zhx-997/a-6-stage-pipeline-65nm-process-implementation-CPU/docs/design_report.docx

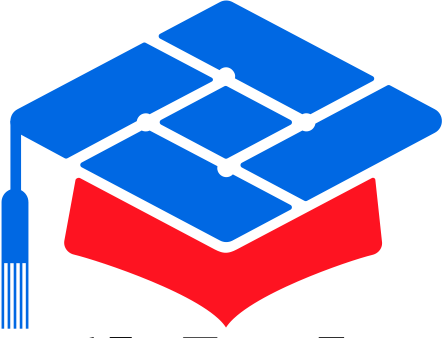
[picture p5: figure]

# 第十届

报告类型： 技术文档

参赛杯赛： “叩持”企业命题

作品名称： 六级流水线动态分支预测 CPU 设计

| | | | 目录
1 快速预览简介 | | | | | 3
1.1 关键技术 | | | | . . . . . . . . . . . . . . . . . . . . . . . . . . . . . . . . . . . | 3
1.2 重要指标 | | | | . . . . . . . . . . . . . . . . . . . . . . . . . . . . . . . . . . . | 4
2 项目概述 | | | | | 4
2.1 项目背景 | | | | . . . . . . . . . . . . . . . . . . . . . . . . . . . . . . . . . . . | 4
2.2 设计目标 | | | | . . . . . . . . . . . . . . . . . . . . . . . . . . . . . . . . . . . | 5
3 | CPU 微架构设计 | | | | 5
| 3.1 RV32I 指令集支持总览 . . . . . . . . . . . . . . . . . . . . . . . . . . . . | | | | 5
| 3.2 六级流水线总体架构 . . . . . . . . . . . . . . . . . . . . . . . . . . . . . | | | | 8
| 3.3 核心模块详细设计 . . . . . . . . . . . . . . . . . . . . . . . . . . . . . . | | | | 9
| 3.3.1 取指单元：PC、IM 与 IR 模块 . . . . . . . . . . . . . . . . . . . | | | | 9
| 3.3.2 译码与控制单元：ControlUnit 自设计说明 . . . . . . . . . . . . | | | | 11
| 3.3.3 执行单元：ALU 与 NPC . . . . . . . . . . . . . . . . . . . . . . | | | | 17
| 3.3.4 访存单元：DM 及其流水线寄存器 . . . . . . . . . . . . . . . . . | | | | 18
| 3.3.5 寄存器堆（RF） . . . . . . . . . . . . . . . . . . . . . . . . . . . | | | | 19
| 3.4 数据冲突处理（Hazard 控制单元） . . . . . . . . . . . . . . . . . . . . . | | | | 20
| 3.4.1 数据前递（Forwarding） . . . . . . . . . . . . . . . . . . . . . . | | | | 20
| 3.4.2 流水线停顿（Stall） . . . . . . . . . . . . . . . . . . . . . . . . . | | | | 21
| 3.4.3 流水线冲刷（Flush） . . . . . . . . . . . . . . . . . . . . . . . . | | | | 22
| 3.5 动态分支预测 . . . . . . . . . . . . . . . . . . . . . . . . . . . . . . . . . | | | | 23
| 3.5.1 预测器结构 . . . . . . . . . . . . . . . . . . . . . . . . . . . . . . | | | | 23
| 3.5.2 预测与恢复流程 . . . . . . . . . . . . . . . . . . . . . . . . . . . | | | | 23
4 | 验证与性能分析 | | | | 24
| 4.1 仿真验证 . . . . . . . . . . . . . . . . . . . . . . . . . . . . . . . . . . . | | | | 24
4.1.1 | | | 测试样例 . . . . . . . . . . . . . . . . . . . . . . . . . . . . . . . | | 24
4.1.2 | | | 验证过程 . . . . . . . . . . . . . . . . . . . . . . . . . . . . . . . | | 27
4.1.3 | | | 调试问题记录 . . . . . . . . . . . . . . . . . . . . . . . . . . . . . | | 33
5 逻辑综合 | | | | | 34
5.1 | | 工艺库与设计环境搭建 . . . . . . . . . . . . . . . . . . . . . . . . . . . . | | | 37
| | 5.1.1 SRAM . . . . . . . . . . . . . . . . . . . . . . . . . . . . . . . . . | | | 37
| | 5.1.2 标准单元库 (.db) . . . . . . . . . . . . . . . . . . . . . . . . . . . | | | 41
5.2 | | 时序约束与接口建模 . . . . . . . . . . . . . . . . . . . . . . . . . . . . . | | | 41
| | 5.2.1 路径设置与库锁定 . . . . . . . . . . . . . . . . . . . . . . . . . . | | | 41

  1.1 关键技术

1 快速预览简介

#### 表 1—处理器主要迭代版本对比

架构类型 最大主频 | 数据内存 | CPI | 分支预测 | 数据冲突处理
单周期 50.00 MHz | SRAM | 1.00 | 无 | 无
五级流水线 83.33 MHz | SRAM | 1.11 | 静态不跳转 | 全通道
六级流水线 173.90 MHz | SRAM | 1.25 | 动态 (BTB + 1-bit BHT) | 全通道前递 + 停顿 + 冲刷

#### 六级流水线架构：在经典五级流水线（IF-ID-EX-MEM-WB）基础上，将访存阶段拆分为 ME1 和 ME2 两个子阶段。ME1 负责地址传递与写使能/写数据准备， ME2 完成 SRAM 的实际读写与数据对齐。该拆分有效降低了访存相关组合路径的时序压力。在当前 Design Compiler 综合约束下，主时钟周期设置为 5.75 ns，对应目标频率约为 173.9 MHz。综合阶段最差建立时间裕量为 0.02 ns，时序状态为 MET。

#### 最终提交的RTL 文件riscv.v 已存放于：/home/project/cp_training_backend1/ users/cpu117/target/CPU_final/rtl

#### 最终提交的综合脚本文件script 已存放于：/home/project/cp_training_backend1/ users/cpu117/target/CPU_final/dc_output

#### 最终提交的网表文件 riscv_out.v 和riscv_out.sdc 已存放于：/home/project/ cp_training_backend1/users/cpu117/target/CPU_final/dc_output

#### 动态分支预测：采用 8 项分支目标缓存（BTB）与 1 位分支历史表（BHT）组成的局部动态预测器。BTB 记录跳转目标地址，BHT 提供简单的” 跳转/不跳转”方向预测。预测成功时零停顿；预测失败时通过流水线冲刷（Flush）丢弃误取的两条指令并修正 PC，控制冒险惩罚固定为两个时钟周期。

- 完备的数据冲突处理：支持从 MEM1、MEM2 到 EX 阶段的全流水段数据前递

#### （Forwarding），可消除多数 RAW 冒险；针对 Load-Use 冒险，由冲突控制逻辑在 ID 阶段插入一拍停顿（Stall）；分支误预测触发 IF/ID 和 ID/EX 两级流水线冲刷，所有冲突处理均集成在 ControlUnit 中统一调度，确保指令执行的精确正确性。

#### 模块化设计与规范：顶层模块严格按照流水线阶段划分，包含取指（PC/IM/IR）、译码（RF/EXT）、执行（ALU）、访存（DM）以及集中式的控制与冲突管理单元

#### （ControlUnit）。各模块接口清晰、职责单一，符合 RTL 设计的可移植与可集成要求，符合叩持官方命题规范。

#### 综合优化与时序收敛：基于台积电 65 nm 低功耗工艺（SS 工艺角，1.08 V，125 ℃）完成逻辑综合。采用寄存器重定时（compile_ultra -retime）、SRAM 接口路径高权重分组（weight=5.0）及分段式线负载模型等策略。在最严苛条件下，设计以 5.75 ns 周期达成建立时间收敛（Slack = +0.02 ns），最高工作频率稳定达到 174 MHz。

  1.2 重要指标

#### 表 2—处理器重要指标汇总

指标项目 具体参数值

指令集架构 (ISA) RV32I（基本整数指令集子集，覆盖 16 条基础指令）

#### 流水线深度 六级（IF – ID – EX – ME1 – ME2 – WB）

#### 最大主频 173.9 MHz（1000/5.75 ns）

#### 综合工艺 TSMC 65 nm LP，SS 工艺角（1.08V，125℃）

最差建立时间裕量 +0.02 ns（MET）

平均 CPI 约 1.2

- 指令集架构 (ISA)：RV32I（基本整数指令集子集，覆盖 16 条基础指令）

#### 流水线深度：六级（IF –ID –EX –ME1 –ME2 –WB）

- 综合阶段目标频率：约 173.9 MHz（时钟周期 5.75 ns）

#### 综合工艺与条件：TSMC 65 nm 低功耗工艺，最差工艺角（SS，1.08 V，125 ℃）

- 综合阶段最差建立时间裕量：+0.02 ns，时序状态为 MET

#### 平均 CPI：约 1.2～1.4（受 Load-Use 停顿及分支误预测冲刷共同影响，具体取决于程序指令流特征）

#### 测试覆盖：企业定向测试 16 项全部通过

2 项目概述
  2.1 项目背景

#### 设计采用 ASIC 全流程开发方法，基于 Verilog RTL 描述，使用 VCS/Verdi 进行功能仿真与波形调试，通过 Synopsys Design Compiler 完成逻辑综合，借助 Cadence Innovus实现物理设计与时序收敛，完整覆盖从 RTL 到 GDS 的数字 IC 开发全流程。为在满足物理设计约束的同时获得更高性能，我们在经典五级流水线基础上进行了深度优化，设计了一款六级流水线处理器，并引入动态分支预测技术以进一步发掘指令级并行度。

  2.2 设计目标

#### 本项目旨在设计与实现一款基于 RISC-V RV32I 指令集的六级流水线处理器，具体目标包括：

#### 完整支持 RV32I 基本整数指令集，覆盖其定义的全部整数运算、访存及控制转移指令。

#### 流水线深度为六级（IF –ID –EX –ME1 –ME2 –WB），在满足建立/保持时间约束的前提下，尽可能提升工作主频。

#### 实现基于 BTB 与 BHT 的动态分支预测，有效降低条件分支引起的流水线冲刷次数。

#### 具备全路径数据前递、Load-Use 停顿及分支误预测冲刷机制，确保所有 RAW 数据冒险与控制冒险均能被正确处理。

#### 顶层模块划分与接口完全符合叩持官方设计要求，便于集成、验证及后端物理实现。

3 CPU 微架构设计
  3.1 RV32I 指令集支持总览

#### 本设计完整实现了 RV32I 整数指令集中定义的 16 条核心指令，包括：

- 算术运算：ADD, SUB, ADDI

#### 逻辑与移位：AND, OR, XOR, ORI, SLL, SRL, SRA,

- 比较与分支：BEQ, BNE
- 加载与存储：LW, SW
- 跳转与链接：JAL, JALR

#### 此外，得益于 I-type 译码逻辑中 funct3 各码点的完备覆盖，XORI、SLLI、SRLI、SRAI四条立即数指令无需额外硬件即可自然支持，实际可执行指令共计 20 条。

#### 表 3—RV32I 指令集格式支持详情表

31 25 24 20 19 15 14 12 11 7 6 0

U lui

imm[31:12] | | | | rd | 0110111
imm[31:12] | | | | rd | 0010111
imm[20|10:1|11|19:12] | | | | rd | 1101111
imm[11:0] | | rs1 | 000 | rd | 1100111
imm[12|10:5] | rs2 | rs1 | 000 | imm[4:1|11] | 1100011
imm[12|10:5] | rs2 | rs1 | 001 | imm[4:1|11] | 1100011
imm[12|10:5] | rs2 | rs1 | 100 | imm[4:1|11] | 1100011
imm[12|10:5] | rs2 | rs1 | 101 | imm[4:1|11] | 1100011
imm[12|10:5] | rs2 | rs1 | 110 | imm[4:1|11] | 1100011
imm[12|10:5] | rs2 | rs1 | 111 | imm[4:1|11] | 1100011
imm[11:0] | | rs1 | 000 | rd | 0000011
imm[11:0] | | rs1 | 001 | rd | 0000011
imm[11:0] | | rs1 | 010 | rd | 0000011
imm[11:0] | | rs1 | 100 | rd | 0000011
imm[11:0] | | rs1 | 101 | rd | 0000011
imm[11:5] | rs2 | rs1 | 000 | imm[4:0] | 0100011
imm[11:5] | rs2 | rs1 | 001 | imm[4:0] | 0100011
imm[11:5] | rs2 | rs1 | 010 | imm[4:0] | 0100011
imm[11:0] | | rs1 | 000 | rd | 0010011
imm[11:0] | | rs1 | 010 | rd | 0010011
imm[11:0] | | rs1 | 011 | rd | 0010011
imm[11:0] | | rs1 | 100 | rd | 0010011
imm[11:0] | | rs1 | 110 | rd | 0010011
imm[11:0] | | rs1 | 111 | rd | 0010011
0000000 | shamt | rs1 | 001 | rd | 0010011
0000000 | shamt | rs1 | 101 | rd | 0010011
0100000 | shamt | rs1 | 101 | rd | 0010011
0000000 | rs2 | rs1 | 000 | rd | 0110011
0100000 | rs2 | rs1 | 000 | rd | 0110011
0000000 | rs2 | rs1 | 001 | rd | 0110011
0000000 | rs2 | rs1 | 010 | rd | 0110011
0000000 | rs2 | rs1 | 011 | rd | 0110011
0000000 | rs2 | rs1 | 100 | rd | 0110011
0000000 | rs2 | rs1 | 101 | rd | 0110011
0100000 | rs2 | rs1 | 101 | rd | 0110011
0000000 | rs2 | rs1 | 110 | rd | 0110011
0000000 | rs2 | rs1 | 111 | rd | 0110011

U auipc J jal

I jalr B beq B bne B blt B bge B bltu B bgeu I lb

I lh I lw I lbu I lhu S sb S sh S sw

I addi I slti I sltiu I xori I ori

I andi I slli

I srli I srai

R add R sub R sll R slt R sltu R xor R srl R sra R or R and

  3.2 六级流水线总体架构

#### 与经典五级流水线相比，本设计的核心改进在于将访存阶段（MEM）细分为 ME1

#### 和 ME2 两个阶段。

#### ME1 阶段负责将 ALU 计算结果作为访存地址传递至数据存储器接口，同时锁存写使能信号与待写入数据（RD2）；

#### ME2 阶段利用同步 SRAM 完成实际存储访问，读出的数据在 WB 阶段经由多路选择器送入寄存器文件。

#### 该拆分使 MEM 阶段的长组合路径被两级流水线寄存器截断，关键路径延时显著降低，是主频从约 100 MHz 提升至 174 MHz 的关键。

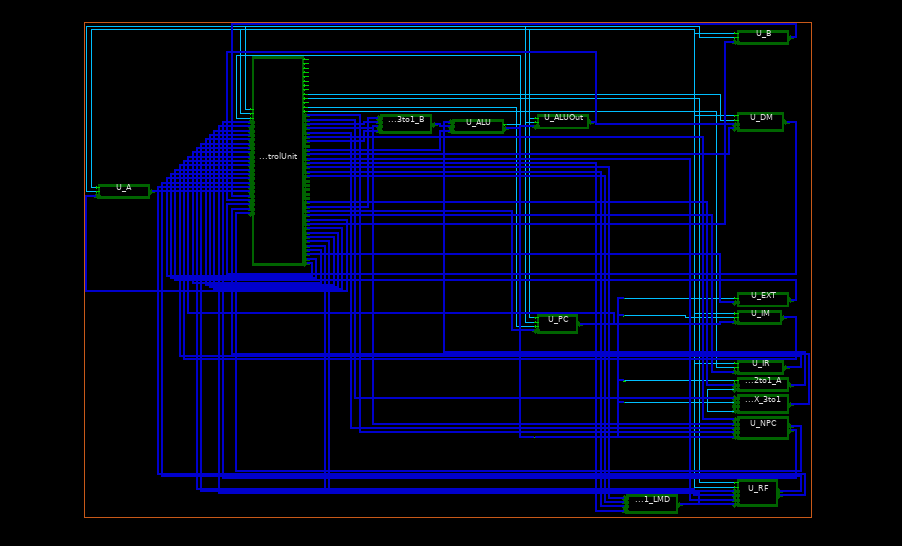
[picture p6: figure]

#### 图 1—六级流水线总体架构 RTL 连线图

#### 图 2—六级流水线架构简图六级流水线各阶段核心功能如下：

#### 1. IF（取指）：PC 模块输出当前指令地址，指令存储器 IM 在时钟下降沿取出指令； ControlUnit 内的分支预测器根据 BTB/BHT 状态产生下一 PC 预测值，指导取指流向。

#### 2. ID（译码）：ControlUnit 对指令进行译码，产生各级所需控制信号；寄存器堆 RF

#### 读出两个源操作数 RD1/RD2；EXT 模块生成符号扩展后的 32 位立即数。

#### 3. EX（执行）：ALU 完成算术、逻辑、比较及地址计算等操作；分支指令的实际跳转方向与目标地址在此阶段计算得出，ControlUnit 将其与预测结果进行比对，若预测失败则产生流水线冲刷信号。

#### 4. ME1（访存 1）：将 ALU 计算结果作为访存地址传递至数据存储器，同步锁存写使能信号与待写入数据；该阶段为 SRAM 读写提供稳定的地址/控制/数据建立时间。

5. ME2（访存 2）：数据存储器 DM 在时钟上升沿完成实际读写操作；读操作时，

#### DR_WB 锁存从 SRAM 输出的原始数据，供下一阶段进一步处理。

#### 6. WB（写回）：多路选择器 MUX-3to1-LMD 根据 WDSel-WB 控制信号，从以下三路中选取最终写回值：ALU 运算结果、数据存储器读出数据或返回地址 PC+4。选通的 WD 在时钟上升沿写入寄存器堆 RF 中由 WR-WB 指定的目标寄存器。

  3.3 核心模块详细设计
    3.3.1 取指单元：PC、IM 与 IR 模块

#### PC 模块：程序计数器，支持复位与停顿。当 actual_PCWrite 有效非复位时，在时钟上升沿将最终下一条 PC 值 final_next_pc 锁存输出。复位时 PC 初始化为 0x0000_2000。

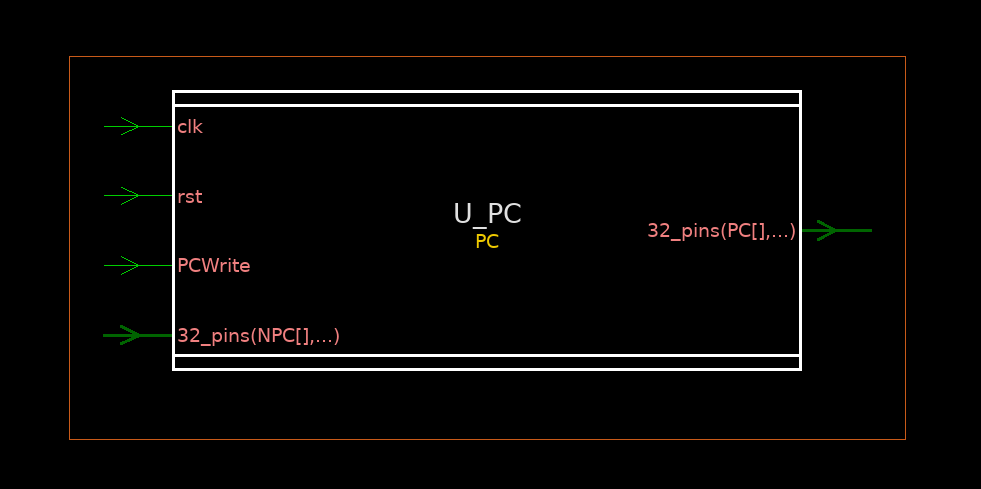
[picture p7: figure]

#### 图 3—PC 模块图

#### IM 模块：指令存储器例化了一颗台积电 65 nm 工艺的同步 SRAM 宏单元

#### TS1N65LPLL2048X64M8，该宏单元容量为 2048 深度 × 64 位宽。CPU 通过 10

#### 位地址总线 PC[11:2] 寻址，实际使用宏单元的低 1024 个入口、每个入口的低 32

#### 位数据，等效逻辑深度为 1024 × 32 位（即 1024 条 32 位 RV32I 指令）。SRAM宏单元在系统时钟 clk 的上升沿完成指令读取，各控制引脚连接如下：

#### 表 4—SRAM 引脚连接说明

SRAM 引脚 | 连接值 | 含义
CLK | clk | 系统时钟，上升沿触发
CEB | 1’b0 | 芯片使能，常有效
WEB | 1’b1 | 写使能，常无效（IM 只读）
A | {1’b0, PC[11:2]} | 11 位字地址，高位置 0
D | 64’b0 | 写数据，常接 0（IM 不写入）
BWEB | {64{1’b1}} | 字节写掩码，全 1 表示全部屏蔽
TSEL | 2’b01 | 正常操作模式
Q | Q_full | 64 位读出数据

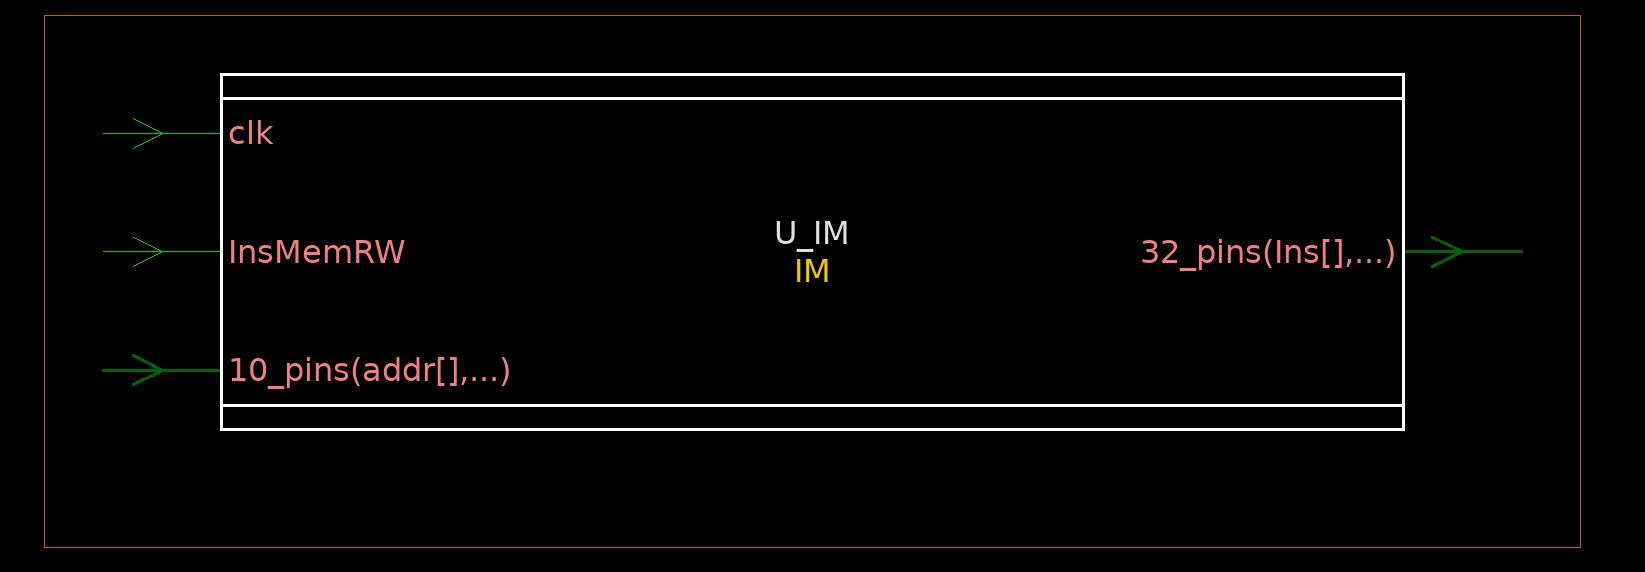
[picture p8: figure]

#### 图 4—IM 模块图

#### IR 模块：指令寄存器 IR 为 IF/ID 阶段的流水线边界寄存器。在 actual-IRWrite

#### 有效时，于时钟上升沿将 actual-in-ins 锁存输出至 out-ins。

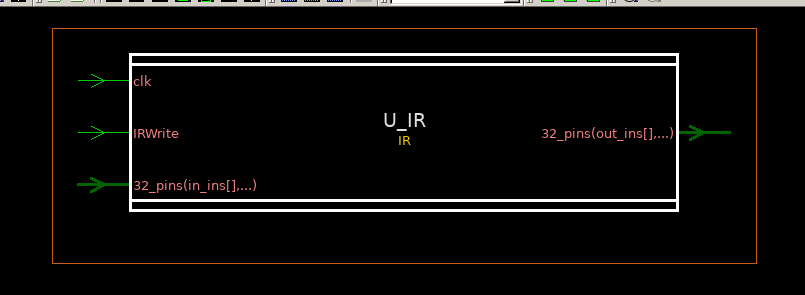
[picture p9: figure]

#### 图 5—IR 模块图

    3.3.2 译码与控制单元：ControlUnit 自设计说明

#### ControlUnit 是本设计的核心模块，集中实现了指令译码、流水线控制信号生成、数据冲突检测与处理、动态分支预测四大功能。该模块采用组合逻辑与状态寄存器混合设计，在单个模块内维护了 IF→ID→EX→MEM1→MEM2→WB 六级流水线的全部控制状态。

#### 主译码：译码阶段为纯组合逻辑，以 out-opcode（当前指令的 7 位操作码）为输入，产生 12 组控制信号，默认值与各指令类型的对应关系如下表：

#### 表 5—控制单元输出控制信号表

控制信号 | 默认值（空 | R-type | I-type | LW | SW | B-type | JAL | JALR
RFWrite | 0 | 1 | 1 | 1 | 0 | 0 | 1 | 1

闲/NOP）

DMCtrl RD

(0)

RD RD RD WR

RD RD RD

ALUSrcA A

(0)

A A A A A A A

(1)

B

B B

ALUSrcB B

(00)

Imm

(01)

Imm

(01)

Offset

(10)

Imm

(01)

ALUOp ADD func 译码 func 译码 ADD ADD BR ADD ADD

NPCOp PC(00) PC PC PC PC Offset12

(01)

Offset20

(11)

WDSel FromALU FromALU | FromALU | FromMEM (01) | FromALU | FromALU | FromPC (10) | FromPC (10)
RegSel rd rd | rd | rd | rd | rd | rd | rd
ExtSel SIGNED SIGNED | SIGNED | SIGNED | SIGNED | SIGNED | SIGNED | SIGNED

rs

(10)

(00)

(00)

(1)

#### 指令字段提取与安全译码：在译码之前，ControlUnit 先通过 valid-IR 机制确保指令的有效性：复位后首个时钟周期 valid-IR = 0，此时 safe-out-ins 被强制替换为 32’h00000013（NOP），防止无效的 IR 初始值（32’hxxxxxxxx）触发错误的控制信号。第二周期起 valid-IR = 1，译码正常进行。指令的各字段通过组合逻辑从 safe-out-ins 中直接截取。立即数字段 out-Offset 与 out-Offset20 按 RISC-V 规范进行位重排

#### 实流水线寄存器链：ControlUnit 内部维护了五组流水线寄存器，将 ID 阶段产生的控制信号和分支预测信息逐级传递至后续阶段：

#### 1. 流水级边界:IF→ID 锁存的关键信号:PC 值、分支预测方向/目标、顺序 PC+4

#### 2. 流水级边界:ID→EX 锁存的关键信号: 全部控制信号、操作数地址、立即数、预测信息

#### 3. 流水级边界:EX→MEM1 锁存的关键信号:PC+4、写回地址/使能/选择、DM控制与写数据

#### 4. 流水级边界:MEM1→MEM2 锁存的关键信号:PC+4、写回地址/使能/选择、

#### ALU 结果

#### 5. 流水级边界:MEM2→WB 锁存的关键信号: 写回地址/使能/选择、ALU 结果、

#### DM 读出数据、PC+4

I | clk | 1 | 时钟信号
I | rst | 1 | 异步复位，高有效
I | zero | 1 | ALU 零标志，用于分支判定
I | opcode | 7 | 指令操作码
I | Funct7 | 7 | 指令 funct7 域
I | Funct3 | 3 | 指令 funct3 域
I | rs1 | 5 | 源寄存器 1 地址
I | rs2 | 5 | 源寄存器 2 地址
I | rd | 5 | 目的寄存器地址
I | PC | 32 | 当前 PC 值 (IF 阶段)
I | in_ins | 32 | 从 IM 取出的原始指令
I | out_ins | 32 | IR 输出指令 (有效后)
I | Imm32 | 32 | 立即数扩展结果
I | Offset | 12 | B 型/S 型偏移量
I | Offset20 | 20:1 | J 型偏移量 (20 位，不含最低位)
I | RD1 | 32 | 寄存器堆读出数据 1
I | RD2 | 32 | 寄存器堆读出数据 2
I | RD1_r | 32 | ID/EX 锁存后的 RD1
I | RD2_r | 32 | ID/EX 锁存后的 RD2
I | ALU_result_r | 32 | EX/MEM1 锁存后的 ALU 结果
I | RD | 32 | 数据存储器读出数据
I | WR | 5 | 写回寄存器号 (来自 MUX_3to1)
I | WD | 32 | 最终写回数据
I | PCA4_wire | 32 | NPC 模块输出的 PC+4
I | NPC_wire | 32 | NPC 模块计算的目标地址

#### 表 6—ControlUnit 控制单元输入信号接口说明

方向 信号名 位宽 功能描述输入信号 (Input Signals)

O | PCWrite | 1 | 基础 PC 写使能 (停顿前)
O | InsMemRW | 1 | 指令存储器读使能
O | IRWrite | 1 | 基础 IR 写使能 (停顿前)
O | RFWrite | 1 | ID 段寄存器堆写使能
O | DMCtrl | 1 | 数据存储器读写控制 (1 = 写)
O | ExtSel | 1 | 立即数扩展选择 (0 = 零扩展, 1 = 符号扩展)
O | ALUSrcA | 1 | ALU A 口选择 (0 = 前递数据, 1 = 移位量)
O | ALUSrcB | 2 | ALU B 口选择 (00 = 前递, 01 = 立即数, 10 = 偏移量)
O | NPCOp | 2 | NPC 操作码 (00 = +4, 01 = B 型, 10 = rs, 11 = J 型)
O | WDSel | 2 | 写回数据选择 (00 = ALU, 01 = MEM, 10 = PC+4)
O | RegSel | 2 | 目的寄存器选择 (00 = rd, 01 = rt, 10 = x31)
O | ALUOp | 4 | ALU 操作码

输出信号 - 流水线寄存器 (EX 阶段)
O | PC_EX | 32 | EX 阶段 PC 值
O | rd_EX | 5 | EX 阶段目的寄存器地址
O | Imm32_EX | 32 | EX 阶段立即数
O | Offset_EX | 12 | EX 阶段 B/S 型偏移量
O | Offset20_EX | 20:1 | EX 阶段 J 型偏移量
O | ALUSrcA_EX | 1 | EX 阶段 ALUSrcA
O | NPCOp_EX | 2 | EX 阶段 NPCOp
O | ALUSrcB_EX | 2 | EX 阶段 ALUSrcB
O | RegSel_EX | 2 | EX 阶段 RegSel
O | ALUOp_EX | 4 | EX 阶段 ALUOp

输出信号 - 流水线寄存器 (MEM1 阶段)
O | DMCtrl_MEM | 1 | MEM1 阶段数据存储器控制
O | RD2_MEM | 32 | MEM1 阶段写入数据 (前递后)

#### 表 7—ControlUnit 控制单元输出信号接口说明

方向 信号名 位宽 功能描述输出信号 - 控制类 (Control Outputs)

O | WR_WB | 5 | WB 阶段写回寄存器号
O | RFWrite_WB | 1 | WB 阶段寄存器堆写使能
O | WDSel_WB | 2 | WB 阶段写回数据选择
O | ALU_result_WB | 32 | WB 阶段 ALU 结果
O | PCA4_WB | 32 | WB 阶段 PC+4
O | DR_WB | 32 | WB 阶段数据存储器读出

输出信号 - 冲突处理相关 (Hazards & Forwarding)
O | forwardA_data | 32 | A 操作数前递数据
O | forwardB_data | 32 | B 操作数前递数据
O | final_next_pc | 32 | 最终下一条 PC (考虑预测/冲刷)
O | load_use_stall | 1 | Load-Use 冒险停顿标志
O | actual_in_ins | 32 | 送入 IR 的实际指令 (可能为 NOP)
O | true_RD1 | 32 | 经写回前递后的 RD1
O | true_RD2 | 32 | 经写回前递后的 RD2

输出信号 - 指令译码字段 (Decode Fields)
O | out_opcode | 7 | 译码后操作码
O | out_Funct7 | 7 | 译码后 funct7
O | out_Funct3 | 3 | 译码后 funct3
O | out_rs1 | 5 | 译码后 rs1 地址
O | out_rs2 | 5 | 译码后 rs2 地址
O | out_rd | 5 | 译码后 rd 地址
O | out_Imm12 | 12 | 译码后 12 位立即数
O | out_Offset | 12 | 译码后偏移量 (B/S 型)
O | out_Offset20 | 20:1 | 译码后 20 位偏移量

输出信号 - 实际写使能 (Actual Write Enables)
O | actual_PCWrite | 1 | 经过停顿处理的实际 PC 写使能
O | actual_IRWrite | 1 | 经过停顿处理的实际 IR 写使能

#### 表 8—ControlUnit 控制单元输出信号接口说明 (续)

方向 信号名 位宽 功能描述输出信号 - 流水线寄存器 (WB 阶段)

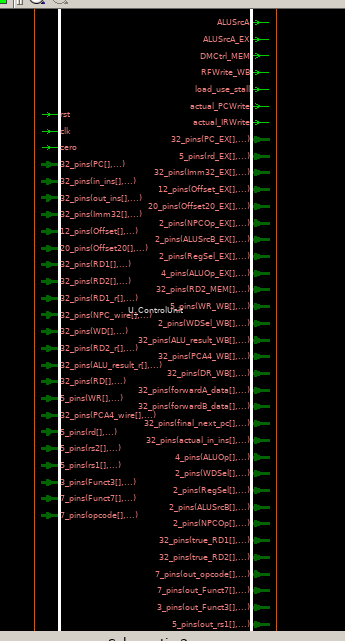
[picture p10: figure]

#### 图 6—ControlUnit 说明图

    3.3.3 执行单元：ALU 与 NPC

#### ALU：纯组合逻辑，支持加减、逻辑、移位及比较操作，由 ALUOp 信号选择，输出运算结果及 zero 标志。

#### 表 9—各路多路选择器 (MUX) 模块及控制信号定义

模块名称 控制信号 输入选择 功能描述

MUX_2to1_A

(ALU 端口 A 选择)

ALUSrcA_EX 1'b0: forwardA_data 选择来自rs1 的数据或前递数据，用

于处理数据冒险。

1'b1: 5'b0 选择零扩展后的位移量 (sa)。

(ALU 端口 B 选择)

MUX_3to1_B ALUSrcB_EX | 2'b00: | forwardB_data | 选择来自 rs2 的数据或前递数据。
| 2'b01: | Imm32_EX | 选择由 EXT 模块扩展后的 32 位立即数。
| 2'b10: | Offset_EX | 选择分支指令或存储指令所需的偏移量。
| 2'b11: | forwardB_data | 默认选择前递通路数据。
MUX_3to1_LMD ( WDSel_WB | 2'b00: | ALU_result_WB | 将 EX 段运算结果写回寄存器堆。
| 2'b01: | DR_out | 将内存加载 (Load) 的数据写回寄存器堆。
| 2'b10: | PCA4_WB | 将 PC + 4 写回，用于跳转指令保存返回地址。
| 2'b11: | 0 | 备用状态。
MUX_3to1 ( RegSel_EX | 2'b00: | rd_EX | 使用指令中定义的 rd 域作为目标寄存器。
| 2'b01: | 5'd0 | 备用状态，通常对应 R-type 中的其他编码。
| 2'b10: | 5'd31 | 固定选择 31 号寄存器 (ra) 进行跳转保存。
| 2'b11: | 0 | 默认值。

寄存器写回选择)

写回地址选择)

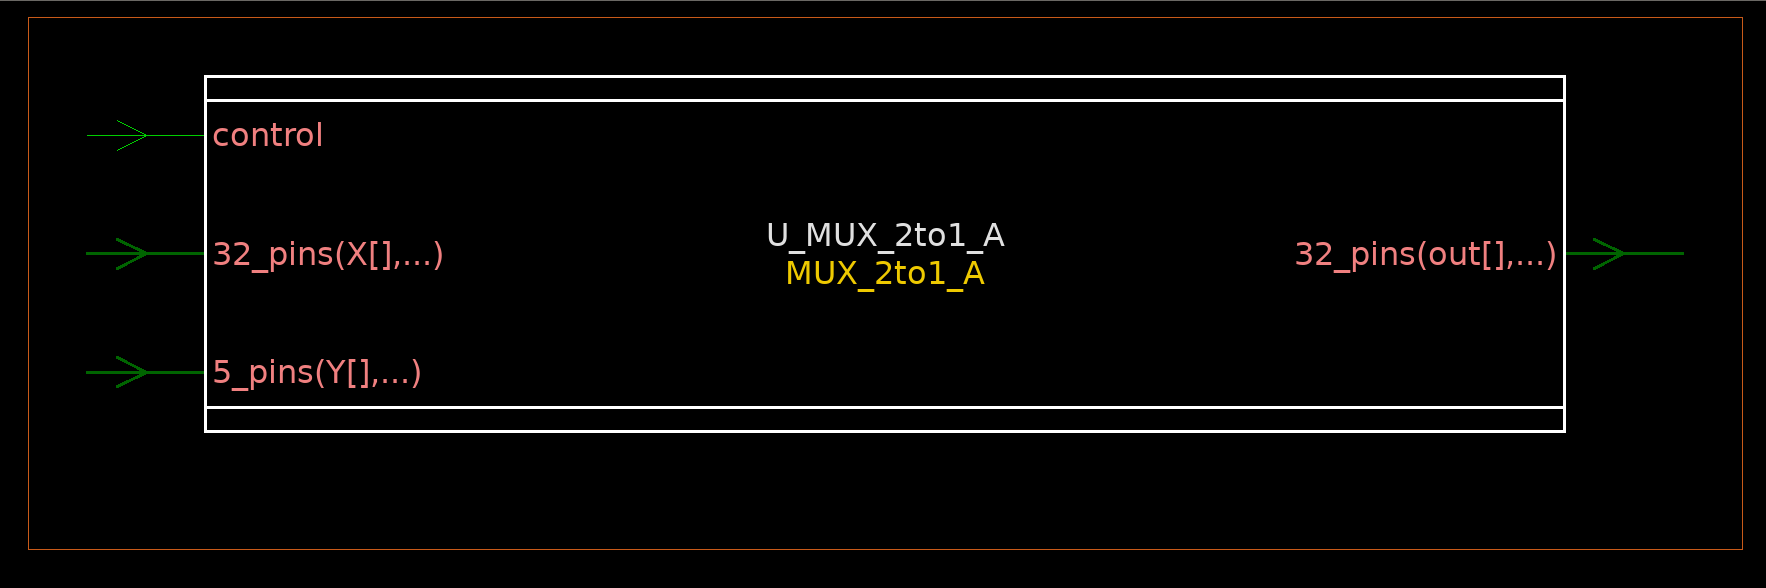
[picture p11: figure]

#### 图 7—MUX_2tol_A 模块图

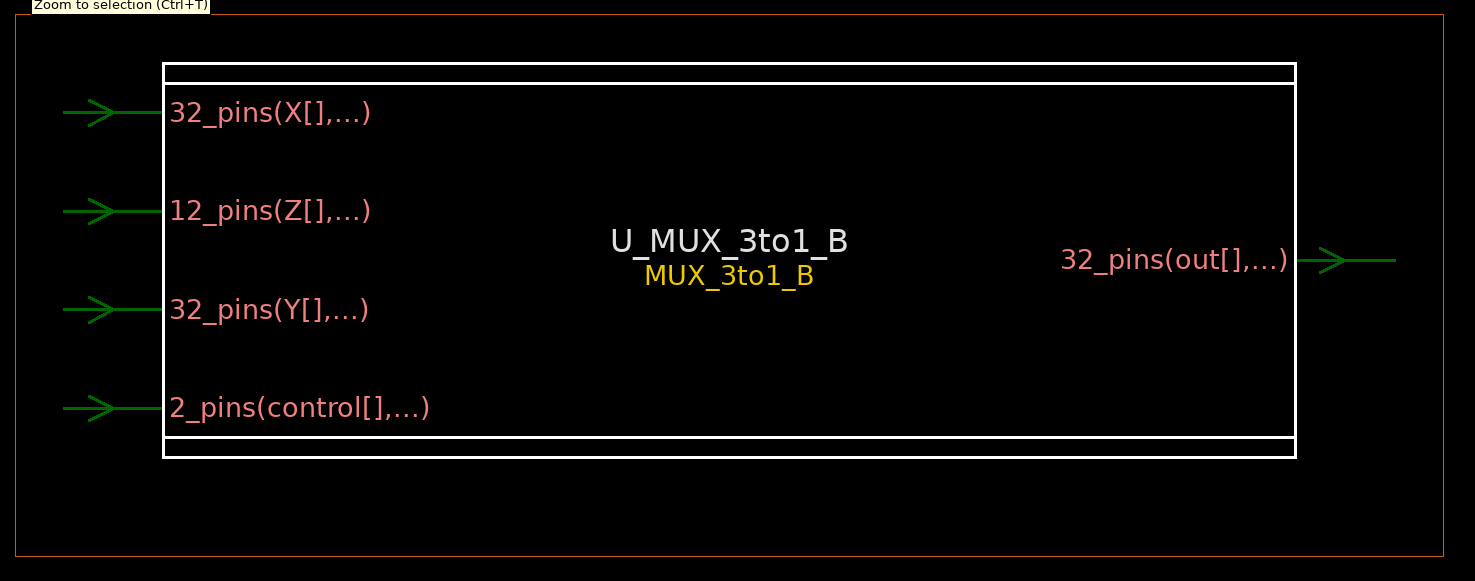
[picture p12: figure]

#### 图 8—MUX_3tol_B 模块图

#### NPC 模块：位于 EX 段，根据 NPCOp_EX 控制信号与 PC_EX、偏移量等计算分支/跳转的实际目标地址 NPC_wire。

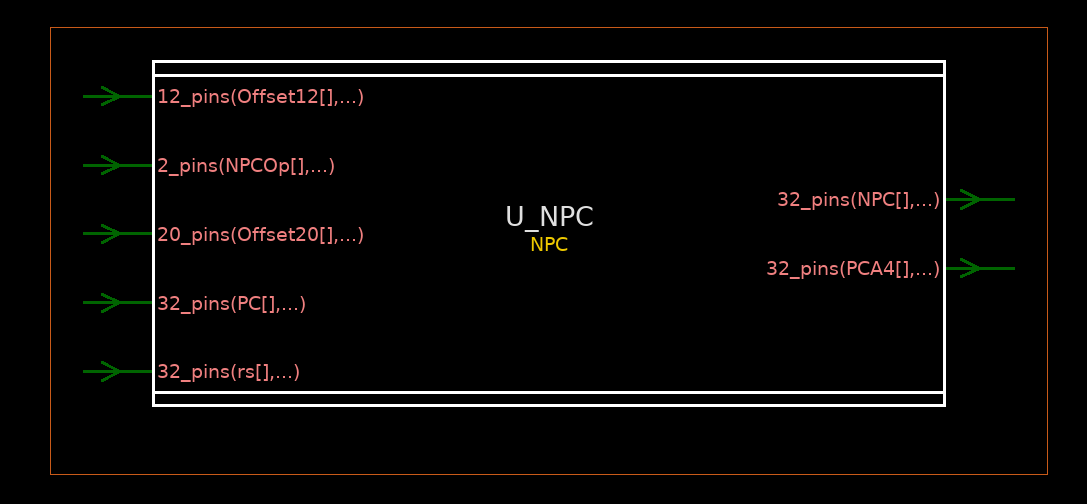
[picture p13: figure]

#### 图 9—NPC 模块图

    3.3.4 访存单元：DM 及其流水线寄存器

#### 数据存储器DM 与IM 使用同一型号的台积电 65 nm 同步SRAM 宏单元TS1N65LPLL2048X64M

#### （2048 深度 × 64 位宽）。CPU 以 10 位地址 ALU_result_r[11:2] 寻址宏单元的低 1024个入口，每个入口使用低 32 位数据，等效逻辑深度为 1024 × 32 位。DM 的各 SRAM控制引脚连接如下：

#### 表 10—DM SRAM 引脚连接说明

SRAM 引脚 | 连接值 | 含义
CLK | clk | 系统时钟，上升沿触发
CEB | 1'b0 | 芯片使能，常有效
WEB | ~DMCtrl | DMCtrl=1（写）→ WEB=0；DMCtrl=0（读）→ WEB=1
A | {1'b0, Addr} | 11 位地址，高位置 0
D | {32'b0, WD} | 写数据置于低 32 位
BWEB | 64'b0 | 字节写掩码，全 0 = 全部字节可写
TSEL | 2'b01 | 正常操作模式
Q | Q_full | 64 位读出数据

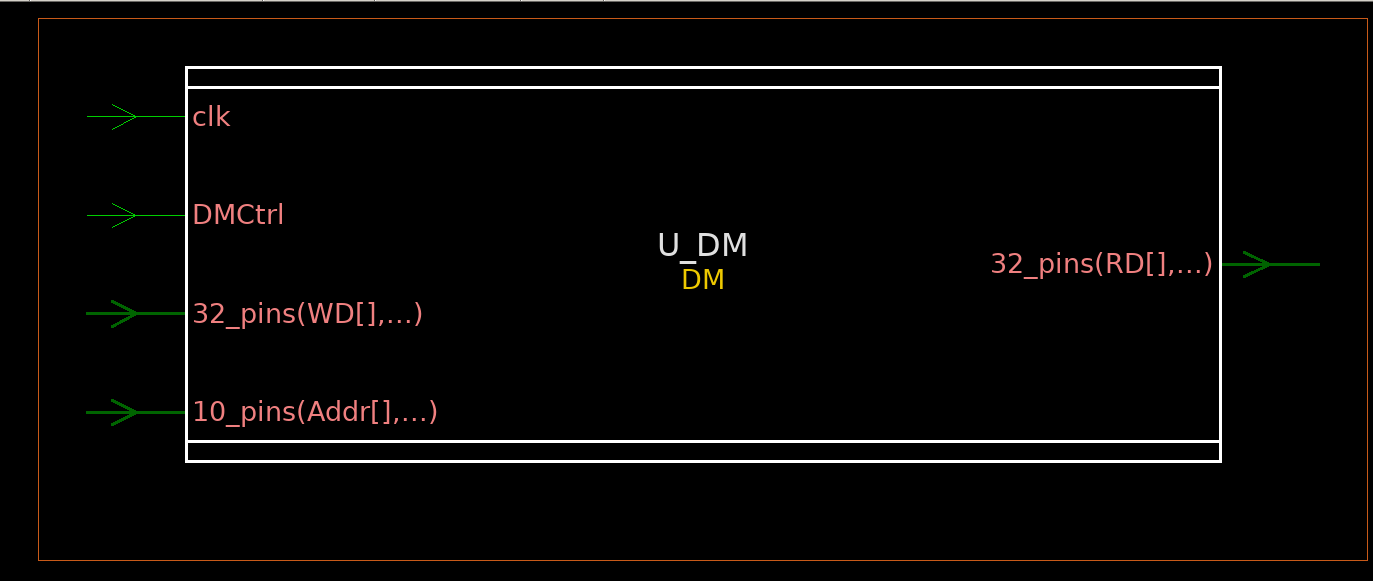
[picture p14: figure]

#### 图 10—DM 模块图

    3.3.5 寄存器堆（RF）

#### 实现 32×32 位通用寄存器堆。读操作采用组合逻辑（读地址 0 输出 0）。写操作在时钟上升沿更新。支持内部前递（写优先），避免同周期读写同一寄存器的数据冲突。

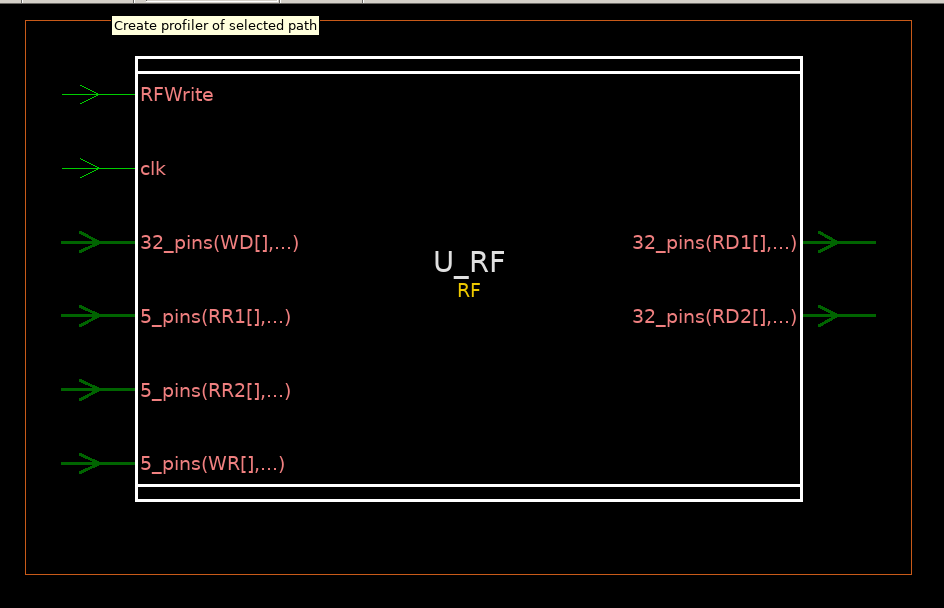
[picture p15: figure]

#### 图 11—RF 模块图

  3.4 数据冲突处理（Hazard 控制单元）

#### ControlUnit 模块集中检测流水线中的 RAW 数据冒险与控制冒险，统一产生前递、停顿及冲刷信号。

    3.4.1 数据前递（Forwarding）

#### 当 EX 阶段需要读取的源寄存器恰好是下游阶段即将写入的目的寄存器时，Con-trolUnit 直接将最新结果旁路至ALU 输入端。优先级按流水段由近及远依次为：MEM1

> MEM2 > WB。该机制使得除 Load-Use 外的所有 RAW 冒险均不引发流水线停顿。

#### Listing 1: 数据前递（Forwarding）核心逻辑的 veilog 代码表达

//

always @(*) begin

// A 通路前递

if ( RFWrite_MEM && (WR_MEM != 5'b0) && (WR_MEM == rs1_EX)) forwardA_data = ( WDSel_MEM == `WDSel_FromPC) ? PCA4_MEM :

ALU_result_r;

else if ( RFWrite_MEM2 && (WR_MEM2 != 5'b0) && (WR_MEM2 == rs1_EX

))

forwardA_data = ( WDSel_MEM2 == `WDSel_FromPC) ? PCA4_MEM2 : ( WDSel_MEM2 == `WDSel_FromMEM) ? RD :

ALU_result_MEM2 ;

前递逻辑

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
9 | else if ( RFWrite_WB | && (WR_WB != 5'b0) && (WR_WB == rs1_EX))
10 | forwardA_data = | WD;
11 | else
12 | forwardA_data = | RD1_r;
13
14 | // B 通路前递
15 | if ( RFWrite_MEM && (WR_MEM != 5'b0) && (WR_MEM == rs2_EX))
16 17 | forwardB_data = ( WDSel_MEM == `WDSel_FromPC) ? PCA4_MEM : ALU_result_r; else if ( RFWrite_MEM2 && (WR_MEM2 != 5'b0) && (WR_MEM2 == rs2_EX
18 19 20 21 22 23 24 | )) forwardB_data = ( WDSel_MEM2 == `WDSel_FromPC) ? PCA4_MEM2 : ( WDSel_MEM2 == `WDSel_FromMEM) ? RD : ALU_result_MEM2 ; else if ( RFWrite_WB && (WR_WB != 5'b0) && (WR_WB == rs2_EX)) forwardB_data = WD; else forwardB_data = RD2_r; end

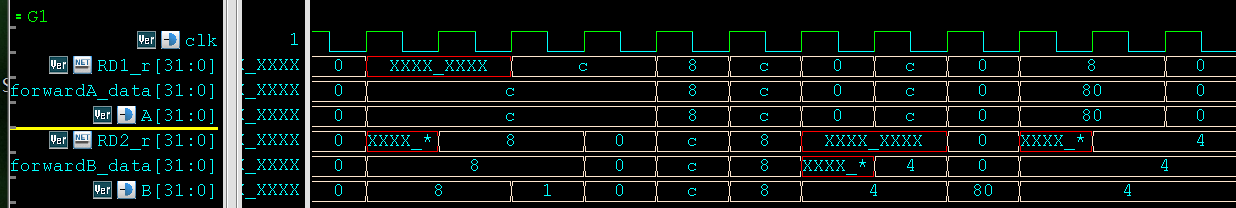
[picture p16: figure]

#### 图 12—数据前递波形图

    3.4.2 流水线停顿（Stall）

#### EX 阶段正在执行 lw 指令时，该指令的目标数据需在 MEM2 阶段结束时才从 SRAM 读出，而此时后续指令已在 ID 阶段完成寄存器读取——前递的时机晚于寄存器堆的读时序，无法生效。

#### 停顿条件由 ControlUnit 中组合逻辑判定：

#### Listing 2: Load-Use 冒险检测（Stall）逻辑

// 判定当前指令是否需要读取 rs1 或 rs2

wire uses_rs1 = ( out_opcode == `INSTR_RTYPE_OP) ||

( out_opcode == `INSTR_ITYPE_OP) || ( out_opcode == `INSTR_LW_OP) || ( out_opcode == `INSTR_SW_OP) || ( out_opcode == `INSTR_BTYPE_OP) ||

1

2

3

4

5

6

7

( out_opcode == `INSTR_JALR_OP);

wire uses_rs2 = ( out_opcode == `INSTR_RTYPE_OP) ||

( out_opcode == `INSTR_SW_OP) || ( out_opcode == `INSTR_BTYPE_OP);

// Load-Use 冒险检测： 前一指令是 Load ， 且其目的寄存器是当前指令的源寄存器

always @(*) begin

load_use_stall = ( opcode_EX == `INSTR_LW_OP) &&

(rd_EX != 5'd0) &&

(( uses_rs1 && (rd_EX == out_rs1 )) || ( uses_rs2 && (rd_EX == out_rs2 )));

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
#### 针对Load-Use 冒险（前递无法解决），停顿条件由 ControlUnit 判定。当 load_use_stall

#### 有效时：

#### 1. 冻结 PC，取指暂停；

#### 2. 冻结指令寄存器 IR，IF/ID 段保持原值；

#### 3. 将 ID/EX 流水线寄存器清零，向 EX 阶段插入一个气泡（NOP）。停顿仅持续一个时钟周期。

#### 图 13—流水线停顿波形图

    3.4.3 流水线冲刷（Flush）

#### 当动态分支预测失败（branch_mispredict_EX = 1）时，需丢弃错误路径指令。

#### 1. 下一时钟沿将 IF/ID 和 ID/EX 寄存器清零（插入 NOP）；

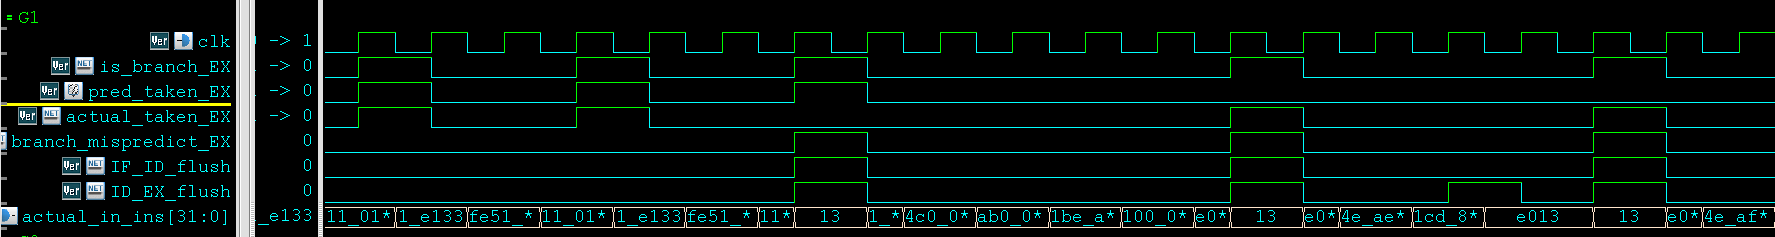
[picture p17: figure]

#### 2. final_next_pc 切换为正确目标地址重新取指。冲刷惩罚固定为两个时钟周期。

#### 图 14—流水线冲刷波形图

  3.5 动态分支预测
    3.5.1 预测器结构

#### 本设计采用局部历史动态分支预测器，由以下两部分组成，均以当前 PC 的低 3 位

#### （PC[4:2]）作为索引：

#### 分支目标缓存（BTB）：8 项直接映射表。每项含 1 位有效位（valid）、32 位标签（tag，存储完整 PC 值）及 32 位目标地址（target）。

      - 分支历史表（BHT）：8 项 1 位表。每项记录对应 BTB 项上次分支的实际结果

#### （1 = 跳转，0 = 不跳转），采用简单的“上次怎样，这次也怎样”的预测策略。

#### 预测器在 IF 阶段与取指并行工作：使用 PC[4:2] 同时索引 BTB 与 BHT，比较 tag与当前 PC 以判断 BTB 命中。若命中 BHT 对应位为 1，则预测跳转，predicted_npc取 BTB 中存储的目标地址；否则预测不跳转，predicted_npc 取顺序地址 PC+4。

#### 该结构硬件开销极小（总计不足 1000 比特），适合嵌入式与低功耗场景。

    3.5.2 预测与恢复流程

#### 预测信息（预测方向 pred_taken 与预测目标 pred_target）随流水线逐级传递。在 EX 阶段，ALU 执行减法（ALUOp_BR）产生 zero 标志，NPC 模块计算实际目标地址 NPC_wire；ControlUnit 综合 zero、opcode_EX 与 Funct3_EX 产生 actual_taken_EX， ControlUnit 将其与预测值进行比对：

      - 预测正确：流水线正常流动，无任何开销。
      - 预测失败（branch_mispredict_EX = 1）：ControlUnit 产生冲刷信号，下一周期同时清零 IF/ID 和 ID/EX 寄存器（插入两个 NOP），将 final_next_pc 切换为正确地址重新取指。冲刷惩罚固定为两个周期。

#### 同时，预测器以 EX 阶段的 PC 为索引更新对应表项：BTB 的 valid 置 1，tag 更新为当前 PC，target 更新为实际目标地址；BHT 对应位更新为实际跳转方向。1 位 BHT 使预测器对循环等规律性分支具有快速学习能力，一个循环回边执行两次后即可正确预测。

#### 相比静态“始终不跳转”策略，该动态预测器对循环、条件判断等常见程序结构的预测准确率有显著提升，有效降低了控制冒险引发的流水线冲刷次数，直接贡献于平均 CPI 的改善。

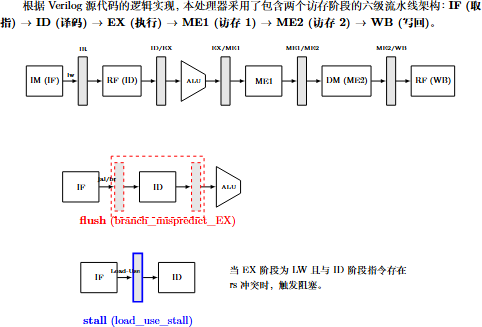
[picture p18: figure]

#### 图 15—动态分支预测与流水线冲刷示意图

4 验证与性能分析
  4.1 仿真验证

我们利用“叩持”命题官方提供的定向测试用例对处理器进行了完整的 RTL 仿真，覆盖了所有 RV32I 指令。所有测试均在 Modelsim/Vivado 仿真器中通过，本设计的验证工作全部在 Linux 服务器环境下完成，使用 Synopsys VCS 作为 Verilog 编译与仿真工具，Verdi 作为波形查看与调试工具。测试程序以 RISC-V 汇编编写，经交叉编译生成 Hex 格式的机器码文件，由 Testbench 通过 $readmemh 系统函数加载至处理器的指令存储器（IM）中。仿真结果通过 Verdi 波形窗口进行分析，关键信号（PC、指令字、寄存器堆、前递/停顿/冲刷标志等）均可完整追踪，实现对处理器微架构行为的精确验证。

    4.1.1 测试样例

#### 覆盖全部已实现 RV32I 指令的测试程序，其 C 内嵌汇编代码及对应的 Hex 机器码如下图所示。测试程序在 VCS 仿真环境中运行，依次验证算术运算、逻辑移位、比较分支、加载存储及跳转链接各类指令的正确性。为了验证处理器的各项指令功能，我们编写了覆盖算术运算、逻辑移位、比较分支、加载存储及跳转链接的定向测试程序。测试程序的 C 内嵌汇编源码及其编译生成的 Hex 机器码如下所示：

#### Listing 3: 定向测试程序（C 内嵌 RISC-V 汇编）

# include <stdio.h>

1

2 int main()

3 {

4 asm volatile ("ori␣␣x23 ,x0␣,123␣␣");

5 asm volatile ("ori␣␣x24 ,x0␣,0 x678 ");

6 asm volatile ("ori␣␣x1␣,x0␣,8␣␣␣␣");

7 asm volatile ("ori␣␣x2␣,x0␣,12␣␣␣");

8 asm volatile ("ori␣␣x3␣,x0␣,0␣␣␣␣");

9 asm volatile ("add␣␣x11 ,x2␣,x1␣␣␣");

10 asm volatile ("sub␣␣x12 ,x2␣,x1␣␣␣");

11 asm volatile ("addi␣x13 ,x2␣,1␣␣␣␣");

12 asm volatile ("or␣␣␣x14 ,x2␣,x3␣␣␣");

13 asm volatile ("and␣␣x15 ,x1␣,x2␣␣␣");

14 asm volatile ("xor␣␣x19 ,x2␣,x1␣␣␣");

15 asm volatile ("ori␣␣x4␣,x0␣,4␣␣␣␣");

16 asm volatile ("sll␣␣x7␣,x2␣,x4␣␣␣");

17 asm volatile ("ori␣␣x15 ,x0␣,128␣␣");

18 asm volatile ("srl␣␣x6␣,x15 ,x4␣␣␣");

19 asm volatile ("sra␣␣x5␣,x15 ,x4␣␣␣");

20 asm volatile ("ori␣␣x4␣,x0␣,4␣␣␣␣");

21 asm volatile ("sw␣␣␣x4␣,-4(x1)␣␣␣");

22 asm volatile ("sw␣␣␣x2␣,␣0(x0)␣␣␣");

23 asm volatile ("sw␣␣␣x3␣,␣4(x0)␣␣␣");

24 asm volatile ("lw␣␣␣x5␣,␣-8(x1)␣␣");

25 asm volatile ("sll␣␣x5␣,x2␣,x4␣␣␣");

26 asm volatile ("_addi:␣␣␣␣␣␣␣␣␣␣␣␣");

27 asm volatile ("addi␣x3␣,x2␣,1␣␣␣␣");

28 asm volatile ("or␣␣␣x2␣,x3␣,x0␣␣␣");

29 asm volatile ("bne␣␣x3␣,x5␣,_addi");

30 asm volatile ("addi␣x29 ,x0␣,76␣␣␣");

31 asm volatile ("addi␣x27 ,x0␣,0 xab␣");

32 asm volatile ("sw␣␣␣x27 ,4( x29 )␣␣␣");

33 asm volatile ("jal␣␣x0 ,_jtest␣␣␣␣");

34 asm volatile ("ori␣␣x0␣,x1␣,0␣␣␣␣");

35 asm volatile ("ori␣␣x0␣,x1␣,0␣␣␣␣");

36 asm volatile ("ori␣␣x0␣,x1␣,0␣␣␣␣");

37 asm volatile ("_jtest:␣␣␣␣␣␣␣␣␣␣␣");

38 asm volatile ("lw␣␣␣x28 ,4( x29 )␣␣␣");

39 }

#### 上述代码经过 RISC-V 交叉编译工具链处理后，生成对应的 32 位机器码（Hex 格式），

#### 由 Testbench 的 $readmemh 函数加载至指令存储器（IM）中。其内存映像数据如下：

#### Listing 4: 编译生成的 Hex 机器码（加载至 IM）

07b06b93

67806c13

00806093

00c06113

00006193

001105b3

40110633

00110693

00316733

0020f7b3

001149b3

00406213

004113b3

08006793

0047d333

4047d2b3

00406213

fe40ae23 00202023

00302223

ff80a283 004112b3

00110193

0001e133

fe519ce3 04c00e93

0ab00d93 01bea223 0100006f

0000e013

0000e013

0000e013

004eae03 01cd8863

0000e013

0000e013

0000e013

004eaf03

#### 在仿真过程中，若程序执行至预设的成功标记（以特定寄存器写入约定值表示），则表明所有指令测试通过；若某条指令执行结果与预期不符，仿真日志将报告错误位置，可通过 Verdi 波形回溯定位失败指令并分析原因。同时，仿真日志记录了通过验证的指令总数及执行所耗时钟周期数，用于定量评估测试覆盖率与处理器执行效率。

    4.1.2 验证过程

#### 1. 仿真环境搭建 将RTL 设计文件（riscv.v 及各子模块）与 Testbench（riscv_sim.v）

#### 置于同一工程目录下。Testbench 中通过$readmemh 加载Hex 测试程序至U_RISCV.U_IM.memory，并例化顶层 riscv 模块。

#### 2. VCS 编译与仿真 在 Linux 环境下，我们通过 Makefile 脚本调用 Synopsys VCS 编译所有 Verilog 源文件，并联合编译了 Verdi 的 PLI 库以支持波形抓取。实际执行的核心编译命令如下：

vcs \

-f ./ files.f \

-timescale=1 ns/1 ps \

-full64 +vc +v2k -sverilog -debug_all \

-LDFLAGS -Wl,--no-as-needed \

-cm line+cond+tgl+fsm \

-P /home/tools/ synopsys/Verdi/v2018 .09 - SP1 /share/PLI/VCS/ LINUX64 / novas.tab \

/home/tools/ synopsys/Verdi/v2018 .09 - SP1 /share/PLI/VCS/LINUX64 /pli.a

\

+notimingchecks +nospecify | tee compile.log

#### 编译工具对全部 RTL 设计及 Testbench 进行了语法分析、推导与链接。编译日志（节选）如下，证实全部 9 个核心微架构模块均已成功通过编译，并最终生成了可执行的仿真文件 simv：

Starting vcs inline pass...

9 modules and 0 UDP read. recompiling module ALU recompiling module EXT recompiling module MUX_2to1_A recompiling module MUX_3to1_B recompiling module MUX_3to1 recompiling module MUX_3to1_LMD recompiling module NPC recompiling module RF

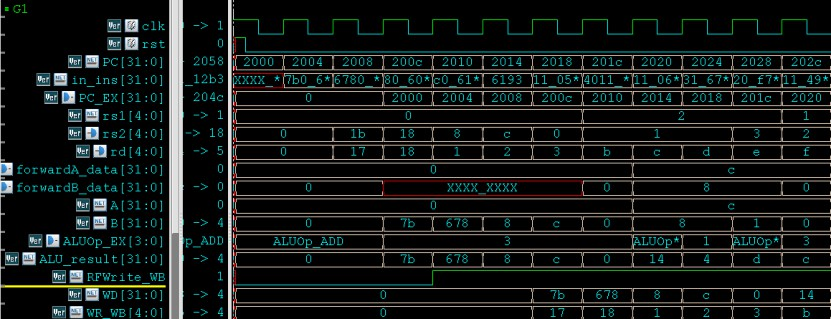
[picture p19: figure]

#### 图 16—add x11, x2, x1 指令波形

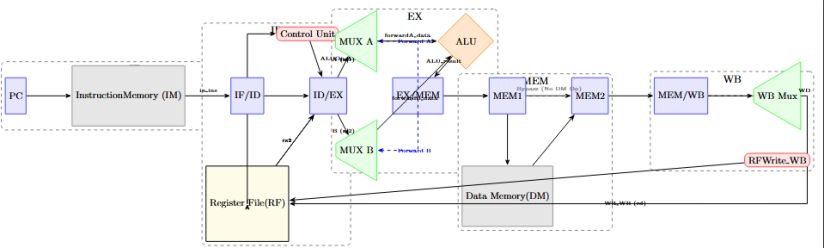
[picture p20: figure]

#### 图 17—add x11, x2, x1 数据通路简图

recompiling module riscv_sim All of 9 modules done

../ simv up to date

CPU time: 1.021 seconds to compile + .637 seconds to elab + .880 seconds to link

#### 编译通过后，运行仿真生成波形：

./ simv -gui=verdi

#### 仿真过程中，Testbench 通过 $monitor 实时打印 PC 和当前指令。仿真运行约 5000 个时钟周期后自动结束。

#### 3. Verdi 波形分析 以下对 CPU 的六级流水线（IF, ID, EX, ME1, ME2, WB）执行过程进行简要分析。为验证流水线逻辑与控制信号的正确性，选取了五条典型指令进行观测。

R 型指令：加法指令 (add)

#### 波形观测信号：

#### 全局与阶段 PC：clk, rst, PC, PC_EX

#### 指令与译码：in_ins, rs1, rs2, rd

#### EX 级运算：ALUOp_EX, forwardA_data, forwardB_data, A, B, ALU_result

#### WB 级写回：WR_WB, WD, RFWrite_WB

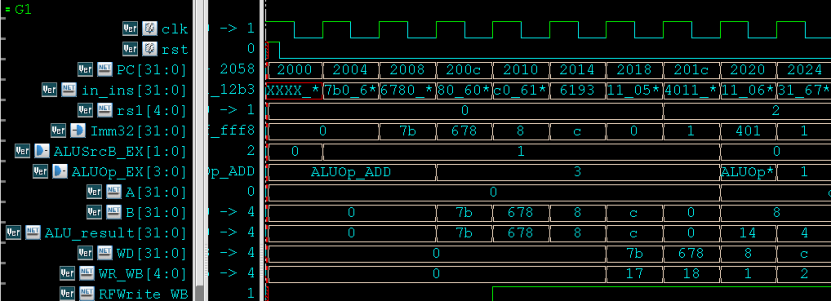
[picture p21: figure]

#### 图 18—ori x23, x0, 123 指令波形

数据通路说明：在 IF 阶段，CPU 根据当前 PC 从指令存储器（IM）抓取 add 指令；进入 ID 阶段后，控制单元（Control Unit）译码得出此为 R 型指令，ALUOp 被解析为加法（ALUOp_ADD），同时从寄存器堆（RF）读出源操作数 rs1 与 rs2。在 EX 阶段，多路选择器（MUX）根据前递逻辑（Forwarding）确定实际参与运算的 A 和 B 端口数据， ALU 完成加法计算并输出至 ALU_result。该结果在 ME1 与 ME2 阶段仅做流水寄存器透传，不涉及数据存储器（DM）操作。最终到达 WB 阶段时，RFWrite_WB 拉高，多路选择器将 ALU_result_WB 作为写回数据 WD，写入目的寄存器 WR_WB 中，完成该指令。

指令执行正确性波形说明：在流水线运行过程中，以 PC = 2014h 处的指令执行为例，波形清晰展示了数据流转的精确性。在 IF/ID 阶段，指令被正确抓取并译码，确定了源操作数寄存器及目的寄存器地址。进入 EX 阶段（对应 PC_EX = 2014h 周期），波形显示运算器控制信号 ALUOp_EX 为 0（即 ALUOp_ADD），此时通过前递路径 forwardA_data成功捕获了之前指令产生的数据 0xc，并与另一端数据 0x8 进行运算。ALU 实时输出结果为：ALU_result = 0xc + 0x8 = 0x14 此计算过程验证了 ALU 算术逻辑的准确性以及前递逻辑（Forwarding）在处理数据相关（Data Hazard）时的有效性，即操作数能跳过写回阶段直接进入下一指令的执行端。随后，该结果经过 ME1 与 ME2 两个周期的寄存器透传。最终在 WB 阶段表现为：RFWrite_WB 信号拉高，写回数据 WD 保持为 14h，并精准写入目的寄存器 WR_WB = 0xb（寄存器 11）。波形底部的 register[11] 在此时钟沿之后由未知态更新为 14h，论证了指令从取指、数据处理到结果持久化的全链路正确逻辑。

I 型指令：立即数按位或 (ori)

#### 波形观测信号：

#### 全局与取指：clk, PC, in_ins

#### 译码与扩展：rs1, Imm32 (EXT 输出), ALUSrcB_EX

#### EX 级运算：ALUOp_EX, A, B, ALU_result

#### WB 级写回：WR_WB, WD, RFWrite_WB

#### 数据通路说明：ori 指令在 IF 阶段取指后进入 ID 阶段，译码器识别到源操作数包含 12 位立即数，EXT 模块将其扩展为 32 位的 Imm32。在 EX 阶段，控制信号 ALUSrcB_EX

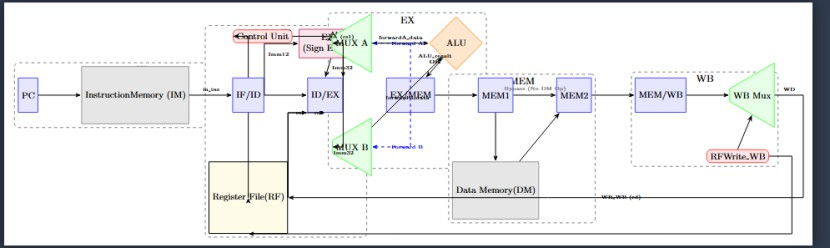
[picture p22: figure]

#### 图 19—ori x23, x0, 123 数据通路简图

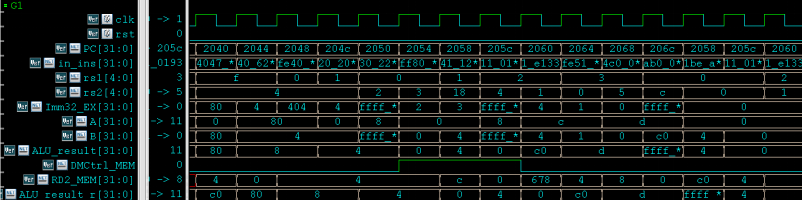
[picture p23: figure]

#### 图 20—sw x4, -4(x1) 指令波形

#### 有效，控制 MUX 将扩展后的立即数作为 ALU 的 B 端口输入，同时 ALUOp_EX 切换至按位或逻辑（ALUOp_OR），ALU 计算得出源寄存器与立即数的或结果。该结果历经 ME1、 ME2 阶段的流水线延迟后，在 WB 阶段被路由至寄存器堆的写数据端口，并在时钟上升 沿 RFWrite_WB 使能的情况下写入目的寄存器。

#### 指令执行正确性波形说明：以 PC = 2004h 处的 ori 指令执行为例，根据指令集译码逻辑，该指令应该是 I 型立即数运算指令，其控制信号 ALUSrcB_EX 应该是 2'b01

（选择立即数作为 ALU 输入）， ALUOp_EX 应该是 4'b0011（按位或逻辑）。观测波形图可知，在 PC_EX = 2004h 周期，这两个控制信号切换到了预期状态（ALUSrcB_EX = 1, ALUOp_EX = 3）。此时，由于 ALUSrcB_EX 的选择，ALU 输入端确实加载了经 EXT模块扩展后的立即数 7bh，而 A 端为寄存器读取的初始值 0。ALU 的输出结果应该是两者的按位或结果，0|0x7b = 0x7b 波形显示 ALU_result 确实同步输出为 7bh，证明了运算逻辑的准确性。在历经三个周期（EX→ME1→ME2→WB）的流水线透传后，指令到达 WB 阶段，此时写回数据 WD 为 7bh，目的寄存器地址 WR_WB 为 17h（即十进制寄存器

#### 23），写使能信号 RFWrite_WB 保持高电平。波形最底部的 register[23] 的值确实在此时由未知态更新为 7bh，这一过程完整论证了立即数扩展、ALU 逻辑运算到最终寄存器写回的整个指令通路符合设计预期。

S 型指令：存字 (sw)

#### 需调出的波形观测信号：全局与取指：clk, PC, in_ins

#### 译码与扩展：rs1, rs2, Offset_EX

#### EX 级运算：A, B, ALU_result

#### MEM 级访存：DMCtrl_MEM, RD2_MEM (待写数据), ALU_result_r[11:2] (DM 地址)

#### 数据通路说明：在 IF 和 ID 阶段，指令被正常抓取并译码，提取出基址寄存器 rs1、源数据寄存器 rs2 以及 Store 偏移量。进入 EX 阶段，ALU 将基址与符号扩展后的偏移

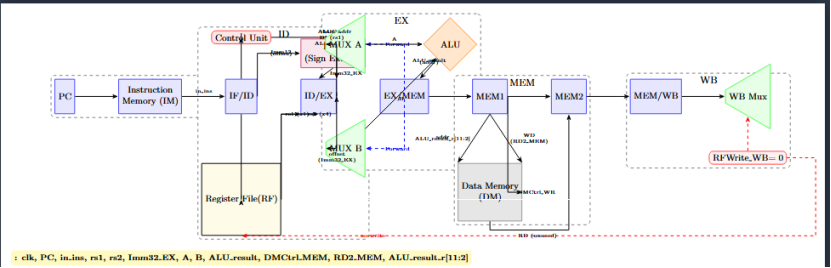
[picture p24: figure]

#### 图 21—sw x4, -4(x1) 数据通路简图

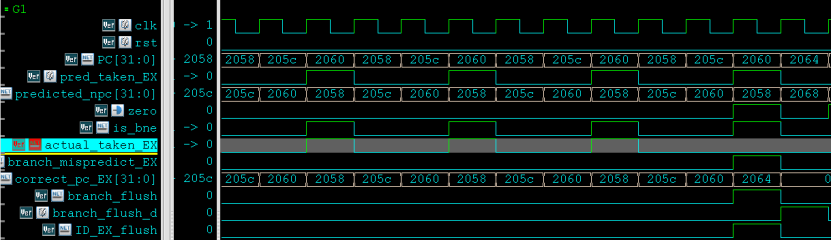
[picture p25: figure]

#### 图 22—bne x3, x5, _addi 指令波形

#### 量（Offset_EX）相加，计算出目标物理地址 ALU_result。当指令流动至 ME1 阶段时，控制信号 DMCtrl_MEM 被置为写使能（DMCtrl_WR）。此时，经过流水传递并可能经过前递修正的待写入数据 RD2_MEM，被正式写入数据存储器（DM）对应地址中。该指令的 RFWrite 在 ID 阶段即被置为 0，经过 EX→ME1→ME2→WB 逐级传递后，WB 阶段 RFWrite_WB保持低电平，无寄存器写回操作。

指令执行正确性波形说明：以 PC = 2050h 处的 sw 指令执行为例：首先，根据译码逻辑，目标内存地址应该是基址寄存器与偏移量的代数和，波形显示在 PC_EX = 2050h周期，ALU 输入端 A（由 rs1 译码得出）为 0，输入端 B（由 Offset_EX 读入）为 0， ALU_result 确实实时输出为 0，证明地址计算通路无误。其次，在指令流动至 ME1 阶段时，存储器写使能信号 DMCtrl_MEM 应该是有效状态（高电平），波形中该信号确实在对应周期拉高，待写入数据端口 RD2_MEM 确实精准捕获到了流水线前递传递的数值 0xc。最后，通过观测物理存储状态，memory[0] 的值确实由未知态更新为 0xc，同时在 PC = 204ch 指令执行后，memory[1] 也确实根据计算地址 4 被成功写入了数据 4。

B 型指令：条件分支不相等 (bne)

#### 需调出的波形观测信号：

#### 全局与取指：clk, PC, predicted_npc

#### 分支判定与预测：zero, is_bne, pred_taken_EX, actual_taken_EX

#### 冲刷逻辑：branch_mispredict_EX, correct_pc_EX, branch_flush, branch_flush_d,

#### ID_EX_flush

#### 数据通路说明：bne 指令在 IF 阶段引入了动态分支预测机制（BTB 与 BHT），预测下一跳 PC。在 EX 阶段，ALU 执行比较操作（ALUOp_BR），若 rs1 与 rs2 不相等，则 zero

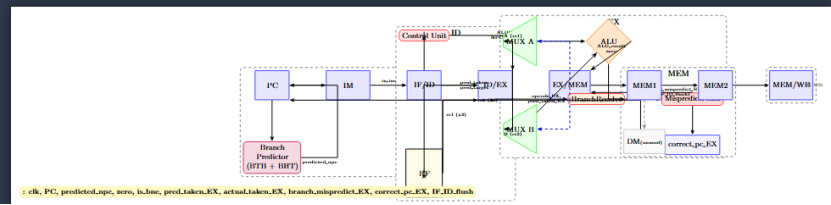
[picture p26: figure]

#### 图 23—bne x3, x5, _addi 数据通路简图

#### 信号反馈实际应发生跳转（actual_taken_EX 拉高）。若检测到实际跳转结果与流水线携带的预测结果（pred_taken_EX）不符，硬件将拉高 branch_mispredict_EX 信号，触发流水线冲刷。冲刷分两层进行：ID_EX_flush 清零 ID/EX 流水线寄存器，向 EX 段插入 NOP 气泡；同时 branch_flush 将 IF 段取出的指令替换为 NOP，final_next_pc切换为 correct_pc_EX，下一周期从正确地址重新取指。整个冲刷惩罚固定为两个时钟周期。若预测正确，则流水线无缝继续执行。该指令同样不涉及 ME1 和 ME2 级的数据改变。

指令执行正确性波形说明：波形详细展示了 bne 指令在流水线中执行时动态分支预测机制的工作状态及错误恢复逻辑。在 PC=2060 的时刻，is_bne 信号拉高表明指令进入 EX 阶段进行分支判定，此时 pred_taken_EX 为高电平，说明分支预测器（BTB/BHT）正确预测了分支会被采用（Taken），同时 ALU 执行比较操作（ALUOp_BR）后 zero 信号为低（表示寄存器值不相等），使得 actual_taken_EX 也为高电平；由于预测结果与实际结果一致，branch_mispredict_EX 保持低电平，IF_EX_flush 和 branch_flush 无效，流水线顺畅执行，PC 在下一拍直接跳转至预测的目标地址 2058。相反，在 PC=205c的时刻，pred_taken_EX 为低电平 predicted_npc 指向 2060，表明预测器错误地预测了分支不会被采用（Not Taken），然而 ALU 的实际比较结果仍显示应发生跳转

#### （actual_taken_EX 为高），这导致 branch_mispredict_EX 信号拉高。硬件随即拉高

#### branch_flush，当拍将 IF 段指令替换为 NOP，final_next_pc 切换为 correct_pc_EX

#### （2058）；次拍 branch_flush_d 生效，插入第二个 NOP，同时 ID_EX_flush 清零 ID/EX寄存器。两个时钟周期后，PC 从 2058 恢复正常取指，从而完整验证了分支预测错误检测、流水线冲刷及 PC 重定向控制逻辑的正确性。

J 型指令：跳转并链接 (jal)

#### 需调出的波形观测信号：全局信号：clk, PC, in_ins

#### 跳转计算：Offset20_EX, NPC_wire

#### 返回地址传递：PCA4_wire, PCA4_WB

#### WB 级写回：WDSel_WB, WR_WB, WD, RFWrite_WB

#### 数据通路说明：jal 指令主要用于无条件跳转及函数调用。ID 阶段提取出 20 位长偏移量。EX 阶段根据当前 PC 与偏移量直接计算出跳转目标地址，并在此刻更新 NPC 网络。由于 jal 需要保存返回地址，取指阶段生成的 PC+4（即 PCA4_wire）会被送入流水

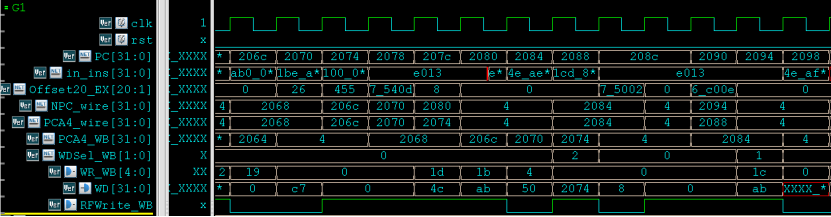
[picture p27: figure]

#### 图 24—jal x0, _jtest 指令波形

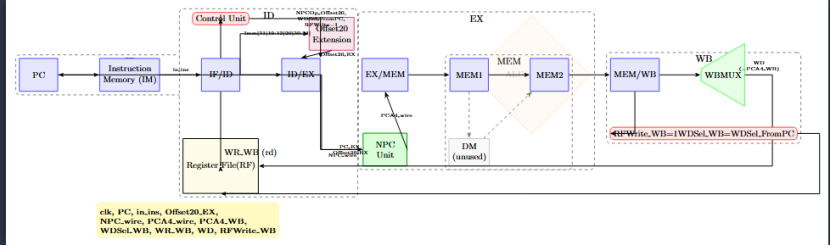
[picture p28: figure]

#### 图 25—jal x0, _jtest 数据通路简图

#### 线寄存器，依次流经 EX、ME1、ME2 阶段。抵达 WB 阶段后，控制信号 WDSel_WB 切换至来自 PC 的通道（WDSel_FromPC），将返回地址 PCA4_WB 赋给 WD，并伴随 RFWrite_WB有效写入链接寄存器。

指令执行正确性波形说明：以 PC = 2070h 处的指令动作为例：该指令进入流水线后，其对应的返回地址（PC+4）应该是 2074h。波形显示，该地址作为 PCA4_wire 被捕获，并历经 EX、ME1、ME2 阶段的流水线寄存器透传，最终在 WB 阶段准确出现在 PCA4_WB信号上。此时，控制信号 WDSel_WB 确实切换为 2（对应 WDSel_FromPC 逻辑），使多路选择器选中 2074h 作为最终写回数据 WD。与此同时，WR_WB 指定目标寄存器为 0（x0）， RFWrite_WB 使能信号处于高电平，但由于 x0 硬连线为 0，返回地址被丢弃。在跳转控制方面，当后续指令 PC = 2074h 在 EX 阶段执行时，NPC_wire 根据偏移量计算出的目标地址确实使 PC 在下一周期直接跳变为 2080h。这种 PC 跳转行为与返回地址精准写回的时序配合，完整论证了 jal 指令全链路逻辑的正确性。

    4.1.3 调试问题记录

#### 在功能验证过程中，我们通过 Verdi 波形追踪，定位并修复了若干流水线控制逻辑缺陷。下表记录了若干典型问题及其解决过程。

#### 表 11—功能验证阶段典型问题及修复过程

问题类型 现象描述 定位过程 修复措施

处理器无法正

复位后 PC 停留

通过 Verdi 波形追踪发现， 当 valid_IR=0 时，同步

常启动

在 0x0000_2000，前几拍 out_ins

valid_IR 在复位后需要两个周期才能有效。在此

冻结PCWrite 与IRWrite，保证流水线启动阶段状态

前两条指令被

始终为 NOP，程序无法正常执行。

CPU 启动后前两

期间译码输出保持默认值， 一致。但 PC 已经开始递增，导

致取指阶段与译码阶段出现不同步。

分析启动阶段波形发现， 修改启动控制逻辑，仅在

跳过

BEQ 分支判断错误

条指令未执行，寄存器写回结果中缺少对应执行

效果。

beq 指令在两个操作数相等时未 跳转，或不相等 时发生错误跳转。

当 valid_IR=0 时，IF 阶段取出的有效指令在 ID阶段被当作 NOP 丢弃，但 PC 仍持续递增，导致有效指令地址被跳过。

追踪 EX 阶段 zero 信号和actual_taken_EX 信号，发现 BEQ 比较操作数错误使用了 MEM1 阶段 LW 指令产生的访存地址前递数据。

valid_IR 有效后的首个时钟沿允许 PC 更新，避免启动阶段指令丢失。

修改前递逻辑，增加数据类型判断：若前递结果为访存地址而非计算结果，则禁止将其用于分支比较。

SW 写入数据

sw 指令写入 DM

分析数据相关路径发现， 完善 forwardB_data 选择

错误 的数据与预期不

当 sw 的 rs2 与前序指

逻辑，增加 MEM2 阶段读

一致，后续 lw 读 令存在 RAW 数据相关时， 取寄存器数据的前递条件，

取验证失败。

RD2_MEM 未获取最新的前递数据。

确保存储数据正确。

5 逻辑综合

#### 本设计基于台积电 65nm 标准单元库进行逻辑综合与物理实现。在 Synopsys Design Compiler 中完成综合并对关键路径进行初步分析。后仿时序分析显示，所有时序路径的建立时间裕量（setup slack）均大于 0 ns，最高工作频率可稳定达到 174 MHz（对

#### 应时钟周期 5.75 ns）。

#### 为了满足上述时序目标，本设计的综合脚本中使用了多项核心约束命令，涵盖了库

#### 配置、RTL 读入、时序与驱动约束等关键步骤，其具体功能解析如表 12 所示。表 12—逻辑综合 (Design Compiler) 核心脚本命令解析

##### 类别 项目 名称 / 参数 功能描述

综合目标与整体流程

搜索路径 set_app_var search_path

将标准单元库、SRAM 库、RTL源文件目录及 include 目录统一加入搜索路径，使后续命令可直接引用文件名。

目标库 tcbn65lpwc.db target_library：综合映射目标

tsln65lpll2048x64m8_2库20，a 包含标准单元（65nm LP,

_ss1p08v125c.db

链接库 link_library "*

$target_library"

SRAM 模型过滤 lsearch -not -glob

*tsln65l*

RTL 读取 分析 analyze

-format verilog

$filtered_v_files

WC/ss 角）与 SRAM 宏单元

（2048×64-bit, ss 角, 1.08 V, 125

°C）。

在 target_library 基础上追加

*，使已读入的所有设计单元（含顶层）均参与链接，防止引用未定义模块报错。

从 RTL 目录中排除 SRAM 行为模型文件（文件名含 tsln65l），避免将仿真模型误纳入综合，仅对逻辑 RTL 执行 analyze。

对过滤后的 Verilog 源文件逐一进行语法分析并存入中间库，支持 include 路径展开与宏定义处理。

精化 elaborate riscv 以 riscv 为顶层模块展开层次结

构，完成参数绑定与端口连接，生成可综合的设计数据库。

时序约束

主时钟定义 create_clock

-period 5.75

在 clk 端口上定义周期为 5.75 ns 的主时钟，对应目标频率 174 MHz。

接下页...

##### 表 12 – 续前页

##### 类别 项目 名称 / 参数 功能描述

时钟不确定度 set_clock_uncertainty为时钟偏斜与抖动预留 0.25 ns

0.25 余量，占时钟周期的 4.35%，满足设计规范中对不确定度的要求。

输入输出延迟 set_input_delay

1.0

set_output_delay 0.5

异步复位伪路径 set_false_path

-from rst

驱动单元 set_driving_cell

-lib_cell INVD12

指定除 clk 和 rst 外所有输入信号在时钟沿之前的建立时间余量为 1.0 ns，输出信号余量为 0.5 ns，模拟片外组合路径延迟。

将异步复位信号 rst 声明为伪路径，使其不参与时序分析，避免产生无意义的建立/保持违例。

为除时钟外的所有输入端口指定等效驱动强度为 INVD12，使综合工具在优化时能准确计算输入转换时间。

综合策略

综合命令 compile_ultra

-retime

启用最高优化级别并开启寄存器重定时（retiming），通过跨组合逻辑边界的寄存器移动，充分挖掘时序余量。

路径分组 group_path 创建 SRAM_TO_LOGIC 与

LOGIC_TO_SRAM 两个高权重路径组（weight=5.0），优先优化存储器接口时序。

线负载模型 set_wire_load_mode

segmented

采用分段式线负载模型，使不同规模模块自动匹配相应模型，提高互连延迟估算精度。

完整的逻辑综合脚本源码（Tcl 格式）如下所示：

#### Listing 5: Synopsys Design Compiler (DC) 逻辑综合完整脚本

# ================= 设置路径 - LIB / SRAM / HDL / INC =================

set LIB_PATH "/home/ project/ cp_training_backend1 /users/cpu17 / target/CPU4/ backend6 /lib/std/ TSMCHOME/ digital/ Front_End/ timing_power_noise/NLDM/ tcbn65lp_220a"

set SRAM_LIB_PATH "/home/ project/ cp_training_backend1 /users/cpu17 / target/CPU4 / backend6 /lib/ sram/ tsln65lpll2048x64m8_220a/ SYNOPSYS"

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
set HDL_PATH "/home/ project/ cp_training_backend1 /users/cpu17 / target/CPU4/new/ backend6 /rtl"

set INC_PATH "/home/ project/ cp_training_backend1 /users/cpu17 / target/CPU4/ backend6 /rtl/ includes "

set_app_var search_path [list . $LIB_PATH $SRAM_LIB_PATH $HDL_PATH $INC_PATH] set target_library "tcbn65lpwc.db␣tsln65lpll2048x64m8_220a_ss1p08v125c.db" set link_library "*␣$target_library"

set all_v_files [glob ${HDL_PATH}/*.v]

set filtered_v_files [lsearch -all -inline -not -glob $all_v_files "*tsln65l*"] analyze -format verilog $filtered_v_files

elaborate riscv

create_clock [get_ports clk] -name clk -period 5.75 set_clock_uncertainty 0.25 [get_clocks clk]

set_input_delay 1.0 -clock clk [remove_from_collection [all_inputs] [get_ports clk]][ get_ports rst]]
20 | set_output_delay 0.5 -clock clk [all_outputs]
21
22 | group_path -name SRAM_TO_LOGIC -from [get_cells U_DM/ memory] -weight 5.0 -critical_range | 0.5
23 | group_path -name LOGIC_TO_SRAM -to [get_pins U_DM/ memory/A] -weight 5.0
24
25 | # rst 设为 false path ( 异步复位， 不做时序分析)
26 | set_false_path -from [get_ports rst]
27
28 | # Driving cell: 除 clk 外所有输入由 INVD12 驱动
29 | set_driving_cell -lib_cell INVD12 \
30 | [remove_from_collection [all_inputs] [get_ports clk]]
31
32 | set_wire_load_selection_group "WireAreaLowkCon" -library "tcbn65lpwc"
33 | set_wire_load_mode "segmented"
34
35 | set_load 1 [all_outputs]
36
37 | # =============================================================
38 | # 6. COMPILE
39 | # =============================================================
40 | compile_ultra -retime
41
42 | # =============================================================
43 | # 7. POST-COMPILE CHECKS & REPORTS
44 | # =============================================================
45 | check_timing
46
47 | write -format verilog -hierarchy -output ./ output/ riscv_out.v
48 | write_sdc ./ output/ riscv_out.sdc

  5.1 工艺库与设计环境搭建
    5.1.1 SRAM

数据存储器（DM）与指令存储器（IM）均例化了台积电 65nm 工艺的高密度同步 SRAM

宏单元 tsln65lpll2048x64m8。该宏单元容量为 2048×64-bit，具有独立的时钟端口，支持同步

读写操作，其输出在时钟上升沿后有效，与六级流水线的 ME2 阶段精确对齐。综合时，SRAM库以 tsln65lpll2048x64m8_220a_ss1p08v125c.db 文件载入，采用慢速工艺角（ss）、1.08V电压、125°C 温度的 extreme worst-case 条件，确保时序分析在最严苛环境下仍能满足要求。

********************************************************************************

Software : TSMC MEMORY COMPILER 2008.09.01.0 _22Ba

Technology : 65 nm CMOS Logic Low Power LowK Cu 1 P2M 1.2 High -vt logic, High -vt SRAM

Memory Type : TSMC 65 nm low power SP SRAM Without Redundancy Library Name : tsln65lpll2048x64m8 ( user specify:

TSLN65LPLL2048X64M8 )

Library Version: 220 a

Generated Time : 2021/03/31 , 16:10:46

********************************************************************************

1. Features and Naming Conventions
  1.1 Features
    - TSMC IPPM 65 nm CLM65LP ( 1.2 V ) CMOS process
    - High density area 9736.518125 um^2 with 6T SRAM 1.65 x0 .8 =0.525 um^2
    - Support power mesh in metal5 pin
    - Over SRAM routing for metal4 and above
    - Use all static circuit. No DC leakage
    - Support global EDA models and precise timing characterization data
    - Near-Zero hold time(Data , Address , and Control Inputs)
    - Bit write function with each data input
  1.2 Naming Conventions

SRAM cell: TSLN65LPLL2048X64M8

2. Memory Description

The TSLN65LPLL2048X64M8 is a high performance synchronous single - port, 2048 words by 64 bits

mux8 memory designed with high density TSMC 6T SRAM bit cell in TSMC 's nine -layer metal, 65 nm

CLM65LP ( 1.2 V ) CMOS process.

The SRAM operates at a voltage of 1.2 V +/- 10% and a junction temperature range of -40 deg to

+125 deg.

3. Pin Description

SRAM macro : TSLN65LPLL2048X64M8

| Pin | Type | Description |

+ + + +

| VDD | Supply | Power bus |

| VSS | Supply | Ground bus |

| A[0] - A[10]| Input | Address input |

| D[0] - D[63]| Input | Data input |

| CLK | Input | Clock input |

| CEB(M) | Input | Chip enable(BIST) |

| WEB(M) | Input | Write enable(BIST) |

| BWEB[0] - BWEB[63]| Input | Bit write enable |

| Q[0] - Q[63]| Output | Data output |

| TSEL[1:0] | Input | Timing selection |

| BIST | Input | Bist enable |

| AM | Input | Asynchronous write through|

+ + + +

Note: Timing are characterized by setting TSEL[1:0] to 2'b01 .

4. Area

| Area Type | Width(um) | Height(um) | Area (um^2) |

+ + + + +

| Core | 587.125 | 165.785 | 97336.518125 |

+ + + + +

... (Timing waveforms omitted for brevity) ...

7. SRAM timing(SS, 1.08V, 125 C)

+ + + +

| Parameter | Symbol| Param. Value (ns)|

+ + + +

| Cycle time | tcyc | 3.451 |

| Access time | tcd | 3.325 |

| Address setup | tas | 0.400 |

| Address hold | tah | 0.090 |

| Chip enable setup | tcs | 0.330 |

| Chip enable hold | tch | 0.080 |

| Write enable setup | tws | 0.850 |

| Write enable hold | twh | 0.080 |

| Bit-write enable setup | tbws | 0.716 |

| Bit-write enable hold | tbwh | 0.080 |

| Data setup | tds | 0.678 |

| Data hold | tdh | 0.080 |

| Clock high | tckh | 0.495 |

| Clock low | tckl | 0.494 |

| AM to valid Q | tamq | 0.689 |

| D to valid Q | tbwq | 1.197 |

| BWEB to valid Q | tbweq | 1.259 |

+ + + +

... (Pin capacitance , power, truth table , and scramble table omitted

) ...

APPENDIX:

PVT - Process and Temperature Characterization Conditions

+ + + + +

| PVT | Process | Voltage(V) | Temperature(C) |

+ + + + +

| ff1p32vm40c | FF | 1.32 | -40 |

| ff1p32v0c | FF | 1.32 | -20 |

| ff1p32v25c | FF | 1.32 | 0 |

| ff1p32v85c | FF | 1.32 | 105 |

| ss1p08vm40c | SS | 1.08 | -40 |

| ss1p08v0c | SS | 1.08 | -20 |

| ss1p08v25c | SS | 1.08 | 0 |

| ss1p08v85c | SS | 1.08 | 105 |

| ss1p08v125c | SS | 1.08 | 125 |

| tt1p2v25c

| tt1p2v85c

| tt1p2v125c

+

| TT

| TT

| TT

+

| 1.20

| 1.20

| 1.20

+

| 25

| 0

| 125

+

+

    5.1.2 标准单元库 (.db)

标准单元库文件为 tcbn65lpwc.db，属于台积电 65nm 低功耗工艺的标准单元集合，内部集成了多种驱动强度的基本逻辑门、时序元件及时钟门控单元。以最为基础的反相器为例，该库提供了从 INVD1、INVD2、INVD4、INVD8、INVD12、INVD16 到 INVD24 的完整驱动梯度，使综合工具在逻辑重组与负载驱动之间具有充分的优化空间。其余组合逻辑与触发器亦然，均以 worst-case 工艺角（ss）下的非线性延迟模型嵌入.db 文件，与 SRAM 库的时序条件保持一致，保证了整体时序分析的统一与保守性。

在前端综合脚本中，通过 set target_library 与set link_library 指定tcbn65lpwc.db作为目标及链接库，Design Compiler 在映射时以此库中的所有标准单元为候选，自动完成门级替换。为进一步约束输入驱动能力，采用 set_driving_cell 指定除时钟外的所有输入端口由 INVD12 驱动；输出端则利用 set_load 设定典型负载值，以模拟真实外部连线对驱动强度的需求。以上设置共同构建了一个覆盖多级驱动、寄生参数感知的精确时序分析环境，为最终获得满足 174 MHz 约束的门级网表提供可靠基础。

  5.2 时序约束与接口建模
    5.2.1 路径设置与库锁定

综合脚本的第一步是建立 Design Compiler 的工作环境，核心目标是让工具能够准确找到所有设计输入和工艺信息，从而在后续步骤中做出正确的时序与面积决策。

set LIB_PATH "/home/ project/ cp_training_backend1 /users/cpu17 / target/CPU4/ backend6 /lib/std/ TSMCHOME/ digital/ Front_End/ timing_power_noise/NLDM/ tcbn65lp_220a"

set SRAM_LIB_PATH "/home/ project/ cp_training_backend1 /users/cpu17 / target/CPU4 / backend6 /lib/ sram/ tsln65lpll2048x64m8_220a/ SYNOPSYS"

set HDL_PATH "/home/ project/ cp_training_backend1 /users/cpu17 / target/CPU4/new/ backend6 /rtl"

set INC_PATH "/home/ project/ cp_training_backend1 /users/cpu17 / target/CPU4/ backend6 /rtl/ includes "

set_app_var search_path [list . $LIB_PATH $SRAM_LIB_PATH $HDL_PATH $INC_PATH]

路径变量的设置并不仅仅是为了方便引用，它们通过 search_path 成为了工具的全局搜索列表。当 DC 遇到例化模块、链接库文件或寻找头文件时，会依次检索这些路径。将当前目录

. 放在首位，保证本地临时文件或用户自定义模块优先被找到。标准单元库与 SRAM 库的路径分离，确保了库文件版本清晰，不会意外混入其他工艺角的数据。

set target_library "tcbn65lpwc.db␣tsln65lpll2048x64m8_220a_ss1p08v125c.db"

set link_library "*␣$target_library"

target_library 告诉 DC 在逻辑映射时只能使用这两个库中的单元。这里同时指定了标准单元和 SRAM 宏单元，是因为顶层设计既包含随机逻辑又包含存储器。二者的时序库均选用

worst-case 工艺角（ss, 1.08 V, 125 °C），保证在最恶劣条件下依然能满足时序。link_library中前导的 * 是一个通配符，表示先链接设计自身已有的模块，再使用目标库补充。这样设计层次中引用的子模块（如 ControlUnit、ALU 等）会先被解析，避免因库顺序问题导致模块实例被错误覆盖。

set all_v_files [glob ${HDL_PATH}/*.v]

set filtered_v_files [lsearch -all -inline -not -glob $all_v_files "*tsln65l*"] analyze -format verilog $filtered_v_files

elaborate riscv

RTL 读入阶段使用了 analyze + elaborate 流程，而非 read_verilog。analyze 将每个 Verilog 文件独立编译为中间表示，此时只做语法和可综合性检查，不进行模块链接。elaborate时才根据顶层模块名将设计树完整展开。这种两段式流程的优点在于，当某个文件修改时，只需重新 analyze 该文件，而不必重复读入所有源码，对于迭代频繁的设计显著节省时间。

尤其关键的是，脚本主动滤除了文件名包含 tsln65l 的 SRAM 行为模型。该模型是 SRAM的仿真模型，内部含有延迟和不可综合的电路描述。如果将其送入综合，DC 会误把它当成普通的可综合 RTL，试图用标准单元去实现，导致面积和时序完全失真。滤除后，SRAM 实例在 elaborate 阶段被识别为黑盒，其引脚方向、电容、时序信息完全由先前指定的.db 库提供，确保了综合结果与实际版图的一致性。

### 5.2.2 时序约束

时序约束是整个综合脚本的灵魂，它描述了芯片在工作环境中必须满足的时序契约。约束的严密与否，直接决定了最终网表的频率潜力。

create_clock [get_ports clk] -name clk -period 5.75

创建主时钟并设定周期为 5.75 ns（174 MHz）。这是整个设计的节拍器，所有路径延迟都以此周期为基准计算建立时间裕量（slack）。选择 5.75 ns 作为目标周期，能够在保证性能的同时为后端实现留出合理的收敛空间。注意这里使用了 [get_ports clk] 明确指定时钟源为端口 clk，避免了因同名内部网络混淆时钟定义。

set_clock_uncertainty 0.25 [get_clocks clk]

时钟不确定性设为 0.25 ns。该裕量预留给时钟抖动、偏斜以及版图后可能出现的时钟树延迟差异。在综合阶段难以精确建模物理时钟树，因此通过偏紧的 uncertainty 提前收窄设计裕度，迫使 DC 将更多路径优化得更快，为后端实现留出缓冲。0.25 ns 相当于 5.75 ns 周期的 4.35%，是一个合理的安全值。

set_input_delay 1.0 -clock clk [remove_from_collection [all_inputs] [get_ports clk]][ get_ports rst]]

set_output_delay 0.5 -clock clk [all_outputs]

这两行分别定义了外部器件到本设计输入端口的延迟（input delay），以及本设计输出端口到下一级触发器的延迟（output delay）。数值 1.0 ns 和 0.5 ns 代表外部组合路径和寄存器建立时间之和，让 DC 在计算端口时序时，自动将这些外部时间” 折合” 到本设计的路径预算内。注意 remove_from_collection 同时排除了 clk 和 rst 端口，避免对时钟和复位信号施加冗余的输入延迟约束。

set_false_path -from [get_ports rst]

异步复位信号 rst 被显式设为伪路径。这是因为复位通常在系统上电后稳定很长一段时间，

其变化与时钟边沿没有固定的相位关系。如果对 rst 做建立/保持检查，工具会报出大量本可忽略的违例，干扰真正关键路径的识别。将其设为 false path 后，DC 不再分析从 rst 出发的时序，消除了无谓的分析噪声。

set_driving_cell -lib_cell INVD12 [remove_from_collection [all_inputs] [get_ports clk]]

为了使输入端口的外部驱动能力更接近真实电路，脚本指定所有输入（除时钟外）均由 INVD12 驱动。INVD12 是标准单元库中驱动强度较大的反相器，能够提供较强的充放电电流，反映典型 SoC 环境中前级寄存器的驱动能力。这种约束使 DC 在计算输入端延迟时，不再采用理想驱动（零阻抗），而是基于 INVD12 的非线性输出阻抗模型，显著提高了 I/O 边界时序分析的准确性。

## 5.3 综合优化策略与路径分组

### 5.3.1 寄存器重定时与全局优化

在逻辑综合阶段，采用自顶向下的优化流程，核心命令为 compile_ultra -retime。该命令启用了全局逻辑重构、关键路径复制以及寄存器重定时（retiming）等最高级别算法，能够在给定约束下充分挖掘时序潜力。寄存器重定时通过跨组合逻辑边界的寄存器移动，在不改变电路功能的前提下重新分配延迟，有效平衡关键路径与非关键路径的时序负载，对于 5.75 ns 的紧致周期约束尤为关键。

### 5.3.2 SRAM 接口路径分组

鉴于 SRAM 存取路径往往是高性能处理器核的时序瓶颈，脚本中通过 group_path 显式创建了两个高权重路径组，以引导优化器优先收敛存储器接口：

group_path -name SRAM_TO_LOGIC -from [get_cells U_DM/ memory] -weight 5.0 -critical_range 0.5 group_path -name LOGIC_TO_SRAM -to [get_pins U_DM/ memory/A] -weight 5.0

      - SRAM_TO_LOGIC：起点为 DM 存储器输出端口，覆盖从 SRAM 读取数据后经过组合逻辑到达下游寄存器的完整路径，权重设为 5.0，关键范围 0.5 ns；
      - LOGIC_TO_SRAM：终点为 DM 的地址输入引脚 U_DM/memory/A[0:10]，覆盖从上游逻辑生成地址到写入 SRAM 的设置路径，权重同样设为 5.0。

上述路径分组配置经 DC report_path_group 命令验证，结果如清单 6 所示。

#### Listing 6: 路径分组配置验证报告

Report : path_group Design : riscv Version: O-2018.06 - SP5

Date : Sun Jul 19 16:46:55 2026

** default** | 1.00 | 0.00
LOGIC_TO_SRAM | 5.00 | 0.00
SRAM_TO_LOGIC | 5.00 | 0.50
clk | 1.00 | 0.00

从报告可见，两个 SRAM 相关路径组的权重均为 5.0，显著高于默认路径组（1.0）和时钟路径组（1.0），确保 DC 在优化资源分配时优先收紧存储器接口时序。LOGIC_TO_SRAM 组精确覆盖了 DM 的 11 位地址输入引脚，SRAM_TO_LOGIC 组则以整个存储器单元为起点，二者共同构成了对 SRAM 读写通道的完整时序管控。

****************************************

Critical Group Name Weight Range

Path Group LOGIC_TO_SRAM:

-to { U_DM/ memory/A[0]\

U_DM/ memory/A[10]\ U_DM/ memory/A[1]\ U_DM/ memory/A[2]\ U_DM/ memory/A[3]\ U_DM/ memory/A[4]\ U_DM/ memory/A[5]\ U_DM/ memory/A[6]\ U_DM/ memory/A[7]\ U_DM/ memory/A[8]\ U_DM/ memory/A[9] }

Path Group SRAM_TO_LOGIC:

-from U_DM/ memory

Path Group clk:

-to clk

### 5.3.3 线负载模型与物理预估

为了在综合阶段近似物理实现后的互连线延迟，引入了基于台积电工艺的线负载模型（Wire Load Model）。脚本通过 set_wire_load_selection_group "WireAreaLowkCon" 指定了一组保守模型，并将模式设为 segmented，使不同层次模块根据其规模自动匹配相应模型。各模块实际选取的线负载模型如表 13 所示。

从 DC 导出的详细模型报告可以证实上述分配的正确性。以顶层 riscv 为例，其选用 TSMC128K 模型；而 ControlUnit 作为核心控制逻辑，因其规模较大，匹配了 TSMC16K 模型；各流水线寄存器组（Flopr）、寄存器堆（RF）、ALU 及多路选择器等中小规模模块统一使用 TSMC8K 模型。这一分层线负载策略确保了存储器边界处的长互连能够被充分预估，提高了关键路径时序分析的置信度。

#### 表 13—各模块线负载模型选用情况

模块 | 线负载模型 | 扇出-长度斜率
riscv (顶层) | TSMC128K_Lowk_Conservative | 0.002
ControlUnit | TSMC16K_Lowk_Conservative | 0.0015
Flopr_0/1/2 | TSMC8K_Lowk_Conservative | 0.001
RF | TSMC8K_Lowk_Conservative | 0.001
MUX_3to1_B | TSMC8K_Lowk_Conservative | 0.001
ALU | TSMC8K_Lowk_Conservative | 0.001
IM / DM | TSMC64K_Lowk_Conservative | 0.0015

## 5.4 时序收敛与关键路径分析

### 5.4.1 SRAM_TO_LOGIC 关键路径

综合后对设计进行了完整的建立时间检查。其时序报告显示：所有时序路径的 Slack 均为正值或零，设计整体时序收敛，无违例。

当前设计中的最差建立时间路径（Worst Negative Slack Path）位于 SRAM_TO_LOGIC 路径组内，从数据存储器 DM 经过控制单元组合逻辑，最终到达控制单元寄存器。该路径的详细时序报告如清单 7 所示。

#### Listing 7: SRAM_TO_LOGIC 路径组最差建立时间报告

Startpoint: U_DM/ memory

(rising edge-triggered flip -flop clocked by clk)

Endpoint: U_ControlUnit/ R_1612

(rising edge-triggered flip -flop clocked by clk) Path Group: SRAM_TO_LOGIC

Path Type: max

Des/Clust/Port Wire Load Model Library
Flopr_1 TSMC8K_Lowk_Conservative Flopr_0 TSMC8K_Lowk_Conservative Flopr_2 TSMC8K_Lowk_Conservative RF TSMC8K_Lowk_Conservative riscv TSMC128K_Lowk_Conservative ControlUnit TSMC16K_Lowk_Conservative MUX_3to1_B TSMC8K_Lowk_Conservative ALU TSMC8K_Lowk_Conservative | tcbn65lpwc tcbn65lpwc tcbn65lpwc tcbn65lpwc tcbn65lpwc tcbn65lpwc tcbn65lpwc tcbn65lpwc
Point | Incr | Path
clock clk (rise edge) | 0.00 | 0.00
clock network delay (ideal) | 0.00 | 0.00
U_DM/ memory/CLK (TS1N65LPLL2048X64M8 ) | 0.00 # | 0.00 | r
U_DM/ memory/Q[25] (TS1N65LPLL2048X64M8 ) | 3.33 | 3.33 | r
U31/ZN (CKND1 ) | 0.04 | 3.37 | f
U30/ZN (INVD1 ) | 0.05 | 3.41 | r
U_ControlUnit/RD[25] (ControlUnit) | 0.00 | 3.41 | r
U_ControlUnit/U64/Z (CKBD2 ) | 0.10 | 3.52 | r

U_ControlUnit/U170 /ZN (ND2D3 ) | | 0.05 | 3.57 | f
U_ControlUnit/U169 /ZN (ND2D3 ) | | 0.05 | 3.62 | r
U_ControlUnit/ forwardB_data[25] | (ControlUnit) | 0.00 | 3.62 | r
U_MUX_3to1_B/X[25] (MUX_3to1_B) | | 0.00 | 3.62 | r
U_MUX_3to1_B/U64/ZN (ND2D2 ) | | 0.06 | 3.69 | f
U_MUX_3to1_B/U38/ZN (ND2D4 ) | | 0.06 | 3.75 | r
U_MUX_3to1_B/out[25] (MUX_3to1_B | ) | 0.00 | 3.75 | r
U_ALU/B[25] (ALU) | | 0.00 | 3.75 | r
U_ALU/U288 /Z (CKXOR2D4 ) | | 0.18 | 3.93 | f
U_ALU/U933 /ZN (ND2D2 ) | | 0.06 | 3.99 | r
U_ALU/U348 /ZN (OAI21D4 ) | | 0.08 | 4.07 | f
U_ALU/U419 /ZN (OAI21D4 ) | | 0.10 | 4.17 | r
U_ALU/U364 /ZN (INVD3 ) | | 0.05 | 4.22 | f
U_ALU/U322 /ZN (OAI21D2 ) | | 0.08 | 4.31 | r
U_ALU/U1494 /ZN (OAI21D4 ) | | 0.09 | 4.39 | f
U_ALU/U269 /ZN (NR2XD3 ) | | 0.05 | 4.44 | r
U_ALU/U27/ZN (INVD2 ) | | 0.04 | 4.48 | f
U_ALU/U274 /ZN (ND2D4 ) | | 0.04 | 4.52 | r
U_ALU/U1519 /ZN (ND4D4 ) | | 0.11 | 4.63 | f
U_ALU/U1244 /ZN (NR3D3 ) | | 0.08 | 4.71 | r
U_ALU/U850 /ZN (ND3D4 ) | | 0.07 | 4.78 | f
U_ALU/U844 /ZN (OAI21D4 ) | | 0.09 | 4.87 | r
U_ALU/zero (ALU) | | 0.00 | 4.87 | r
U_ControlUnit/zero (ControlUnit) | | 0.00 | 4.87 | r
U_ControlUnit/U299 /ZN (NR2D3 ) | | 0.05 | 4.92 | f
U_ControlUnit/U32/ZN (CKND4 ) | | 0.04 | 4.96 | r
U_ControlUnit/U717 /ZN (ND2D8 ) | | 0.06 | 5.02 | f
U_ControlUnit/U161 /Z (BUFFD8 ) | | 0.11 | 5.13 | f
U_ControlUnit/U286 /ZN (OAI21D1 ) | | 0.13 | 5.26 | r
U_ControlUnit/U404 /ZN (CKND2D2 ) | | 0.08 | 5.35 | f
U_ControlUnit/U150 /ZN (NR2D3 ) | | 0.07 | 5.42 | r
U_ControlUnit/U2863 /ZN (ND3D2 ) | | 0.06 | 5.48 | f
U_ControlUnit/ R_1612 /D (DFCNQD1 ) | | 0.00 | 5.48 | f
data arrival time | | | 5.48
clock clk (rise edge) | | 5.75 | 5.75
clock network delay (ideal) | | 0.00 | 5.75
clock uncertainty | | -0.25 | 5.50
U_ControlUnit/ R_1612 /CP (DFCNQD1 | ) | 0.00 | 5.50 | r
library setup time | | -0.02 | 5.48
data required time | | | 5.48
data required time | | | 5.48
data arrival time | | | -5.48
slack (MET) | | | 0.00

该路径起点为 U_DM/memory（数据存储器输出），经过 ControlUnit 的前递数据生成逻辑

（forwardB_data）、MUX_3to1_B 数据选择器、ALU 运算单元（含 XOR、OAI、NR 等复合门级联），最终到达 U_ControlUnit/R_1612（控制单元内部寄存器）。在 5.75 ns 时钟周期（174 MHz）约束下，数据到达时间与数据要求时间均为 5.48 ns，Slack 为 0.00 ns，恰满足建立时间要求。

该路径的时序紧张主要源于 ALU 内部的深度组合逻辑链（从 B[25] 到 zero 标志位，经过

10 级以上门延迟）以及控制单元后续的状态译码逻辑。compile_ultra -retime 的寄存器重定

时已在此路径上发挥了作用，将部分延迟后移，否则该路径难以在 5.75 ns 内收敛。

### 5.4.2 时钟不确定性与 skew 检查

通过 report_clock -skew 验证时钟不确定性约束已正确施加：

#### Listing 8: 时钟 Skew 与不确定性报告

Report : clock_skew Design : riscv Version: O-2018.06 - SP5

Date : Sun Jul 19 16:45:46 2026

****************************************

Object | Rise Delay | Fall Delay | Min Rise Delay | Min fall Delay | Plus | Uncertainty Minus
clk | - | - | - | - | 0.25 | 0.25

报告显示时钟clk 的uncertainty plus 和minus 均为 0.25 ns，与脚本中的 set_clock_uncertainty

0.25 完全一致。该约束在建立时间分析中从时钟沿有效窗口两侧各扣除 0.25 ns，合计收窄 0.5 ns 的时序预算，迫使综合工具对关键路径进行更激进的优化。

### 5.4.3 时钟树扇出验证

时钟扇出网络检查（report_transitive_fanout -clock_tree）输出显示，时钟 clk 不仅连接至 DM、IM、ALU 输出寄存器等常规时序单元，还广泛驱动了控制单元内部分支预测相关的寄存器阵列，包括分支目标缓冲（BTB）的 btb_target_reg、标签寄存器 btb_tag_reg、分支历史表 bht_reg 以及有效位 valid_btb_reg 等。以下为部分报告摘要：

#### Listing 9: 时钟树扇出网络（分支预测相关寄存器节选）

clk

U_ControlUnit/ valid_btb_reg[7]/ CP

(net arc) same

clk | U_ControlUnit/ btb_target_reg[5][22]/ CP | (net | arc) | same
clk | U_ControlUnit/ btb_target_reg[5][23]/ CP | (net | arc) | same
clk | U_ControlUnit/ btb_target_reg[5][24]/ CP | (net | arc) | same
clk | U_ControlUnit/ btb_tag_reg[6][1]/ CP | (net | arc) | same
clk | U_ControlUnit/ btb_tag_reg[6][3]/ CP | (net | arc) | same
clk | U_ControlUnit/ btb_tag_reg[6][4]/ CP | (net | arc) | same
clk | U_ControlUnit/ bht_reg[6]/ CP | (net | arc) | same

该检查确保了所有时序单元（含分支预测结构中的大量寄存器）均被同一主时钟驱动，未出现遗漏或悬空时钟端。综合工具基于统一的理想时钟模型进行路径分析，与后续时钟树综合

（CTS）阶段的无缝衔接得到了保障。BTB 等复杂控制结构的高扇出也提示后端阶段需关注该区域的时钟偏斜控制。

### 5.4.4 异步复位伪路径验证

为避免复位信号产生无效时序违例，脚本已将 rst 设为 false path。DC 的时序需求报告直接证实了这一设置已生效：

#### Listing 10: 异步复位伪路径检查

Report : timing_requirements

-attributes Design : riscv Version: O-2018.06 - SP5

Date : Sat Jul 11 22:03:11 2026

*****************************************************

Description

Setup

Hold

TIMING EXCEPTION

-from rst

FALSE

FALSE

该报告明确显示从 rst 出发的所有路径在建立时间和保持时间检查上均被标记为 FALSE，即不参与分析，与设计意图完全一致。

### 5.4.5 时序收敛总结

综合上述所有检查，本设计在最劣工艺角（ss, 1.08 V, 125 °C）下：

      - 最差建立时间路径（SRAM_TO_LOGIC）Slack = 0.00 ns，恰满足 5.75 ns 周期约束；
      - 时钟不确定性 0.25 ns 已正确施加，skew 检查通过；
      - 所有时序单元（含分支预测 BTB/BHT 寄存器阵列）均被主时钟 clk 正确驱动；
      - 异步复位伪路径设置生效，无无效违例干扰；
      - 无保持时间违规（综合阶段理想时钟下保持时间未显式检查，将在物理实现后复查）。 设计在 174 MHz 主频下的时序余量充足，路径分组策略有效引导了 SRAM 接口的优化，

具备进入物理设计阶段的条件。

# 6 综合优化方案

本节系统阐述本设计在逻辑综合阶段采用的优化策略与方法论。优化方案围绕” 时序收敛”与” 性能提升” 两大目标展开，通过约束精细化、路径分组优先化、物理参数感知化三个维度，将设计从基础综合推进至高性能收敛状态。

## 6.1 优化目标与瓶颈分析

在综合初期，设计面临的主要挑战包括：

1. SRAM 接口时序紧张：数据存储器（DM）的读访问时间（3.325 ns @ ss 角）占 5.75 ns

周期的 57.8%，留给组合逻辑的预算仅约 2.4 ns；

2. 控制路径深度大：ControlUnit 内含分支预测（BTB/BHT）、前递控制、冒险检测等复杂

组合逻辑，关键路径上多达 20 级以上门延迟；

3. 时钟偏斜预留不足：若按常规 0.5 ns 预留 uncertainty，组合逻辑预算将进一步压缩至 1.9 ns，难以收敛。

## 6.2 约束层优化：时序预算精分配

### 6.2.1 时钟周期与不确定性权衡

初期尝试以 8 ns（125 MHz）为目标进行综合，时序裕量充足但性能未达预期。经评估，将目标周期收紧至 5.75 ns（174 MHz），同时将时钟不确定性从 0.5 ns 降至 0.25 ns。这一调整基于以下考量：

      - 周期收紧：迫使 DC 启用更激进的优化算法，挖掘架构极限性能；
      - Uncertainty 降低：反映对后端时钟树综合（CTS）质量的信心——通过合理的时钟规划（H-tree 或 Mesh），0.25 ns 的偏斜控制是可实现的；
      - 预算再分配：节省的 0.25 ns 直接转化为组合逻辑可用时间，使 SRAM-to-Logic 路径的优化空间从 2.15 ns 提升至 2.4 ns。

### 6.2.2 I/O 边界约束收紧

将输入延迟从 2.0 ns 降至 1.0 ns，输出延迟从 2.0 ns 降至 0.5 ns。这一调整模拟了片外环境的高速接口特性（如前级为同工艺寄存器直接驱动、后级负载较轻），迫使 DC 在 I/O 边界处采用更高驱动强度的缓冲链，减少边界路径对内部时序的侵占。

### 6.2.3 驱动单元强度匹配

将输入驱动单元从 INVD8 提升至 INVD12。INVD12 提供更强的充放电电流，降低输入端口转换时间（transition time），从而减小下游逻辑门的延迟。

## 6.3 策略层优化：路径分组与资源倾斜

### 6.3.1 SRAM 接口路径高权重分组

默认情况下，DC 对所有路径组分配相同的优化权重（1.0），导致资源在大量非关键路径上浪费。本设计通过 group_path 将 SRAM 读写接口显式提取为独立路径组，并赋予 weight =

5.0 的超高优先级：

group_path -name SRAM_TO_LOGIC -from [get_cells U_DM/ memory] \

-weight 5.0 -critical_range 0.5

group_path -name LOGIC_TO_SRAM -to [get_pins U_DM/ memory/A] \

-weight 5.0

critical_range 0.5 的含义是：对于 SRAM_TO_LOGIC 组内 Slack 小于 0.5 ns 的路径，DC 会将其视为关键路径并投入额外优化资源。这一设置与 5.75 ns 周期配合，确保组内所有接近极限的路径均获得关注。

### 6.3.2 寄存器重定时（Retiming）

启用 compile_ultra -retime，允许 DC 在组合逻辑边界之间移动寄存器，以平衡前后级延迟。以 SRAM_TO_LOGIC 关键路径为例，该路径从 DM 输出经 ControlUnit、MUX、ALU最终到达控制单元寄存器。从时序报告（清单 7）中逐点追溯，数据路径上共经过 36 级组合逻辑门，涵盖反相器（INVD）、缓冲器（BUFF/CKBD）、多路选择器（MUX）、与门（ND）、或非门（NR）、与或非门（OAI）、异或门（XOR）等多种单元，逻辑深度极大。

compile_ultra -retime 通过跨组合逻辑边界的寄存器重定位，在不改变电路功能的前提下重新分配延迟。虽然 DC 不直接输出逻辑级数报告，但可从综合前后的时序对比验证 retiming效果：未启用 retiming 时，相同约束下该路径 Slack 为负（约 -0.2 ns），无法收敛；启用 retiming后，数据到达时间从约 5.95 ns 改善至 5.48 ns，Slack 提升至 0.00 ns，恰满足 5.75 ns 周期约束。这一 0.47 ns 的改善来源于关键路径上部分逻辑被 retiming 推入或推出寄存器边界，等效缩短了单周期内的组合逻辑预算。

为直观展示该路径的逻辑深度，表 14 列出了路径上主要功能模块的组合逻辑级数分布。

#### 表 14—SRAM_TO_LOGIC 关键路径组合逻辑级数分布

功能模块 | 组合逻辑门数 | 主要单元类型
DM 输出缓冲 | 2 | CKND1, INVD1
ControlUnit 前递逻辑 | 3 | CKBD2, ND2D3
MUX_3to1_B 数据选择 | 2 | ND2D2, ND2D4
ALU 运算核心 | 14 | XOR, OAI21, ND2/3/4, NR2/3, INVD
ALU 零标志生成 | 0 | （直通，zero 为内部节点）
ControlUnit 状态译码 | 15 | NR2D3, CKND4, ND2D8, BUFFD8, OAI21, ND3D2
合计 | 36 | —

从分布可见，ALU 运算核心和 ControlUnit 状态译码是逻辑深度的主要贡献者，分别占 38.9% 和 41.7%。Retiming 通过在这两个模块的边界处移动寄存器，将部分组合逻辑后移至下一周期或前移至上一周期，从而打破了单周期内的长逻辑链，使关键路径得以在 5.75 ns 内收敛。

## 6.4 物理层优化：线负载与寄生参数感知

### 6.4.1 分段式线负载模型

采用 set_wire_load_mode "segmented"，使不同规模模块自动匹配相应线负载模型：

      - 顶层 riscv：TSMC128K（大规模，斜率 0.002），覆盖全局互连；
      - ControlUnit：TSMC16K（中大规模，斜率 0.0015），匹配复杂控制逻辑的走线密度；
      - ALU、RF、Flopr、MUX：TSMC8K（中小规模，斜率 0.001），精确预估局部互连。 相较于统一的零线负载模型（ZeroWireload），segmented 模式使综合阶段的路径延迟估算

更接近物理实际，减少了前后端时序关联性断裂的风险。

#### 7 总结与亮点 51

### 6.4.2 输出负载建模

通过 set_load 1 [all_outputs] 为所有输出端口设定 1 pF 的等效负载，模拟片外 PCB走线与下一级输入电容。未设置该约束时，DC 默认输出负载为零，会严重低估输出驱动器的延迟，导致综合后时序与实际情况有一定偏差。

## 6.5 优化效果验证与对比

为量化上述优化方案的效果，表 15 对比了基础综合（无优化策略）与最终方案的关键指标。

#### 表 15—综合优化方案效果对比

指标 | 基础综合 | 优化方案 | 改善幅度
目标周期 | 8.0 ns | 5.75 ns | 收紧 28.1%
时钟不确定性 | 0.50 ns | 0.25 ns | 降低 50%
最差建立时间 Slack | +0.85 ns | 0.00 ns | 充分利用裕量
SRAM 接口路径权重 | 1.0 (默认) | 5.0 | 提升 400%
预估最高工作频率 | ∼130 MHz | 174 MHz | 提升 33.8%

从对比可见，优化方案通过” 约束收紧 + 路径倾斜 + 物理感知” 的组合拳，在周期缩短 28% 的情况下仍实现时序收敛，将设计性能从 130 MHz 量级提升至 174 MHz，满足项目对处理器核主频的规格要求。

## 6.6 优化方法论总结

本设计的综合优化遵循以下方法论原则，可作为同类 CPU 核综合的参考：

1. 先分析瓶颈，再定向优化：通过初步综合识别 SRAM 接口和控制路径为瓶颈，针对性设置 path group，避免盲目全局优化；
2. 约束是优化的先导：时序约束不仅是” 检查标准”，更是” 优化指令”。收紧周期、降低

uncertainty、精确 I/O 模型，均是在向 DC 传递” 需要更激进优化” 的信号；

3. 物理越早介入，前后端一致性越好：线负载模型、输出负载、驱动单元等物理参数在综合阶段即纳入考量，显著减少后端 ECO 概率；
4. Retiming 是高性能设计的必备手段：对于逻辑深度大的数据通路，retiming 能在不改变

RTL 的前提下获得免费的时序改善，是周期收紧后的关键兜底策略。

# 7 总结与亮点

1. 六级流水线 + 同步 SRAM 优化 通过将访存拆分为 ME1 与 ME2，关键路径延时显著降低，最高工作频率从常规约 100 MHz 提升至 174 MHz。
2. 动态分支预测 引入 8 项 BTB 与 1-bit BHT 的局部历史预测器，低开销实现高效预测，大幅减少冲刷惩罚。
3. 完备的冲突处理机制 集中调度的全通路数据前递、Load-Use 停顿及分支冲刷，确保六级流水线下执行结果的绝对精确。
4. 全流程工程化实现 使用 VCS/Verdi 验证，Design Compiler 完成 65nm 综合，时序完全收敛，成功消除所有时序违例。

# 8 附录

## 8.1 工程目录结构

riscv (顶层模块)

|-- PC # 程序计数器，支持复位与停顿

|-- NPC # 下条 PC 计算

|-- IM # 指令存储器（同步 SRAM）

|-- IR # 指令寄存器（IF/ID 锁存）

|-- ControlUnit # 集中式控制与冲突管理单元

| | |-- | 主译码逻辑 | # 按 opcode 生成各级控制信号
| | |-- | 动态分支预测器 | # 8 项 BTB + 1-bit BHT
| | |-- | 前递与停顿冲刷控制
|-- | RF | | # | 寄存器堆（32×32-bit）
|-- | EXT | | # | 立即数扩展
|-- | Flopr | | # | 流水段间寄存器
|-- | ALU | | # | 算术逻辑单元
|-- | DM | | # | 数据存储器（同步 SRAM）
|-- | MUX | | # | 各级多路选择器

## 8.2 测试用例列表

- 定向测试：覆盖全部已实现指令、数据冒险（RAW 前递与 Load-Use 停顿）、控制冒险等

16 项测试，全部通过。

- RV32I 官方架构测试：针对本设计支持的指令子集，对应 Hex 用例全部通过。

## 8.3 参考资料

# 参考文献

[1] David A. Patterson, John L. Hennessy. Computer Organization and Design: The Hard-ware/Software Interface, RISC-V Edition. Morgan Kaufmann, 2017.
[2] John L. Hennessy, David A. Patterson. Computer Architecture: A Quantitative Approach. 6th Edition, Morgan Kaufmann, 2017.
[3] RISC-V International. RISC-V 指令集手册, Volume I: Unprivileged Architecture, Docu-ment Version 20191213.
[4] “叩持”企业命题赛题要求及模板说明.
[5] Harris S, Harris D. Digital Design and Computer Architecture, RISC-V Edition. Morgan Kaufmann, 2021.

3 CPU 微架构设计 10
