zhx-997/a-6-stage-pipeline-65nm-process-implementation-CPU/rtl/DM.v

// C:\Users\zhx de pc\Desktop\CPU117\.release\rtl\DM.v
//
// Module `DM` of the 6-stage pipelined RISC-V RV32I CPU.
// Split from the original single-file riscv.v; logic unchanged.
//
`include "riscv_defines.v"

module DM( Addr,WD,clk,DMCtrl,RD);
    input [11:2] Addr;        
    input [31:0] WD;          
    input clk;                
    input DMCtrl;            
    output reg [31:0] RD;    

    reg [31:0] memory[0:1023];
    always @(posedge clk) begin 
        if (DMCtrl) begin
            memory[Addr] <= WD; 
        end
        else begin
            RD <= memory[Addr]; 
        end
    end 
    endmodule
