zhx-997/a-6-stage-pipeline-65nm-process-implementation-CPU/rtl/EXT.v

// C:\Users\zhx de pc\Desktop\CPU117\.release\rtl\EXT.v
//
// Module `EXT` of the 6-stage pipelined RISC-V RV32I CPU.
// Split from the original single-file riscv.v; logic unchanged.
//
`include "riscv_defines.v"

module EXT(imm_in,ExtSel, imm_out);
    input [11:0] imm_in;
    input ExtSel;
    output reg[31:0] imm_out;

    always@(imm_in or ExtSel) begin
        case(ExtSel)
            `ExtSel_ZERO   :imm_out = {20'b0,imm_in[11:0]};
            `ExtSel_SIGNED :imm_out = {imm_in[11] ? 20'hfffff : 20'h00000 ,imm_in[11:0]};
            default        :imm_out = 32'b0;
        endcase
    end
    endmodule
