zhx-997/a-6-stage-pipeline-65nm-process-implementation-CPU/rtl/NPC.v

// C:\Users\zhx de pc\Desktop\CPU117\.release\rtl\NPC.v
//
// Module `NPC` of the 6-stage pipelined RISC-V RV32I CPU.
// Split from the original single-file riscv.v; logic unchanged.
//
`include "riscv_defines.v"

module NPC(NPCOp, Offset12, Offset20, PC, rs, PCA4, NPC);
    input [1:0] NPCOp;
    input [12:1] Offset12;
    input [20:1] Offset20;
    input [31:0] PC;
    input [31:0] rs;
    output reg [31:0] PCA4;
    output reg [31:0] NPC;

    wire signed [12:0] Offset13;
    wire signed [20:0] Offset21;


    assign Offset13 = $signed({Offset12[12:1], 1'b0});
    assign Offset21 = $signed({Offset20[20:1], 1'b0});

    always@(*) begin
        case(NPCOp)
            `NPC_PC       : NPC = PC + 4;
            `NPC_Offset12 : NPC = $signed({1'b0, PC}) + $signed(Offset13);
            `NPC_rs       : NPC = rs;
            `NPC_Offset20 : NPC = $signed({1'b0, PC}) + $signed(Offset21);
            default       : NPC = PC + 4;
        endcase
        PCA4 = PC + 4;
    end
    endmodule
