zhx-997/a-6-stage-pipeline-65nm-process-implementation-CPU/(commit log)

2026-09-14 六级流水线动态分支预测 RISC-V RV32I CPU 设计（TSMC 65nm，125 MHz）
    - 六级流水线（IF-ID-EX-ME1-ME2-WB），访存拆分缩短关键路径
    - 动态分支预测：8 项 BTB + 1-bit BHT
    - 全路径数据前递 + Load-Use 停顿 + 分支误预测冲刷
    - 经 VCS/Verdi 仿真验证，Design Compiler 综合时序收敛
2026-09-15 修正 README：最大主频 125MHz → 174MHz（决赛版综合结果）
2026-09-15 Add docs & assets, revamp README (174 MHz)
    - docs/: 决赛版技术文档 PDF/DOCX（脱敏版）、仿真说明、答辩 PPT（脱敏版）
    - assets/: 架构图、分支预测器、时序报告、retiming 优化、SRAM 引脚图
    - README: 重写为带图表、指标、文档链接的精美版
    - 主频修正为 174 MHz（5.75 ns，决赛版综合结果）
2026-09-15 替换 pipeline_arch.png：原为空白占位图，替换为真实六级流水线架构图
2026-09-15 重构: 拆分 riscv.v 为多模块工程, 新增仿真与综合脚本
    - rtl/: 单文件 riscv.v 拆分为 riscv_defines.v(宏) + 15 个模块文件, 逻辑逐字一致
    - legacy/riscv_singlefile.v: 原单文件备份对照
    - sim/: riscv_sim.v testbench + test_program.hex(37条) + files.f + run_sim.sh
    - synth/: dc_synth.tcl (5.75ns/retime/SRAM分组) + README
    - README: 更新工程结构与快速开始
