zhx-997/a-6-stage-pipeline-65nm-process-implementation-CPU/(notices)

Notices in the files:
README.md:
License: MIT
